ALPause23/Diplom/Презентация.pptx

## Аппаратно-программный комплекс измерения скорости объекта

Подготовил: Кабринович Е.Н.
Руководитель: байрак с.а.

## Цели и задачи

Целью данного дипломного проекта является разработка комплекса по измерению скорости объекта. Также, есть и дополнительные функции: измерение напряжения на аккумуляторной батарее автомобиля, часы реального времени с корректировкой, а также количество видимых устройством спутников.
- Проанализировать литературу.
- Составить структурную и функциональную схему прибора.
- Анализ и выбор необходимых компонентов.
- Разработка структуры программы управления контроллером.
- Составить электрическую принципиальную схему.
- Написание программного кода управления контроллером.

## Выбор навигационной системы

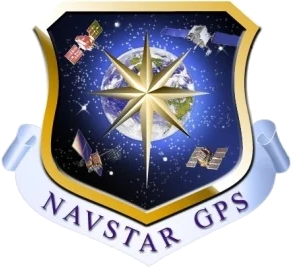
[picture p3: figure]
GPS — Википедия

VS

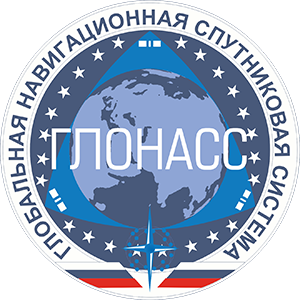
[picture p4: figure]
ГЛОНАСС (Глобальная навигационная спутниковая система ...

## Навигационная система GPS

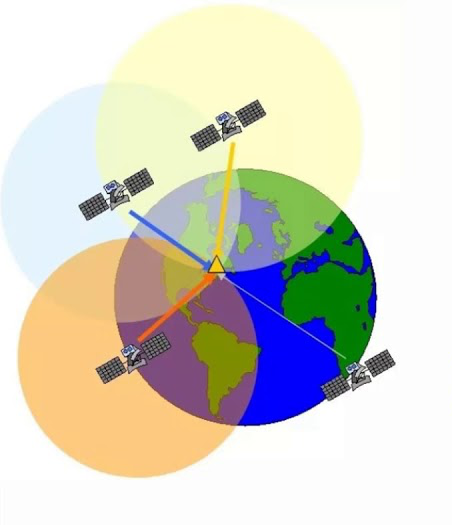
[picture p5: figure]
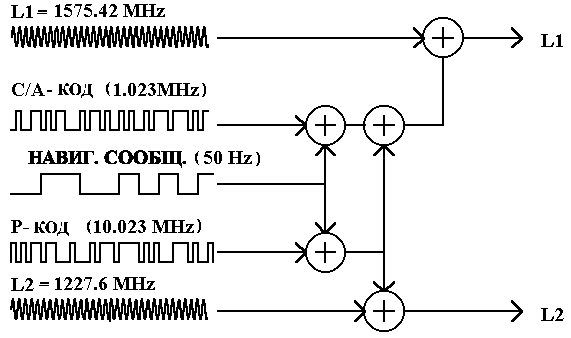
[picture p6: figure]
Кодирование радиосигнала

## Структура аппаратно-программного комплекса

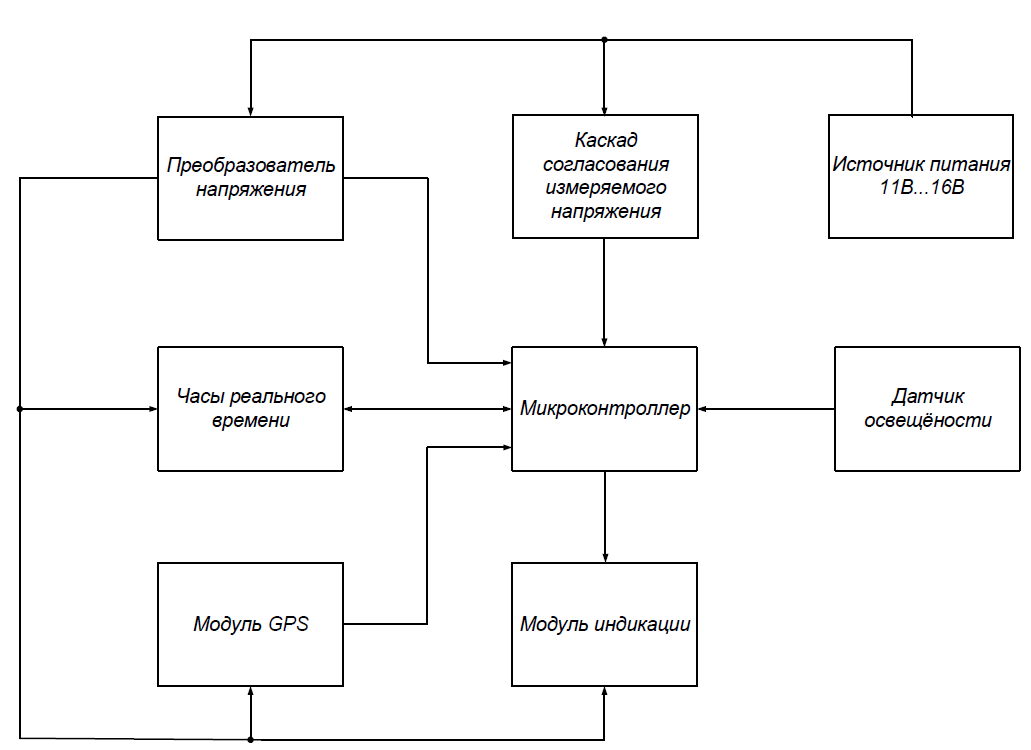
[picture p7: figure]

## Функционал аппаратно-программного комплекса

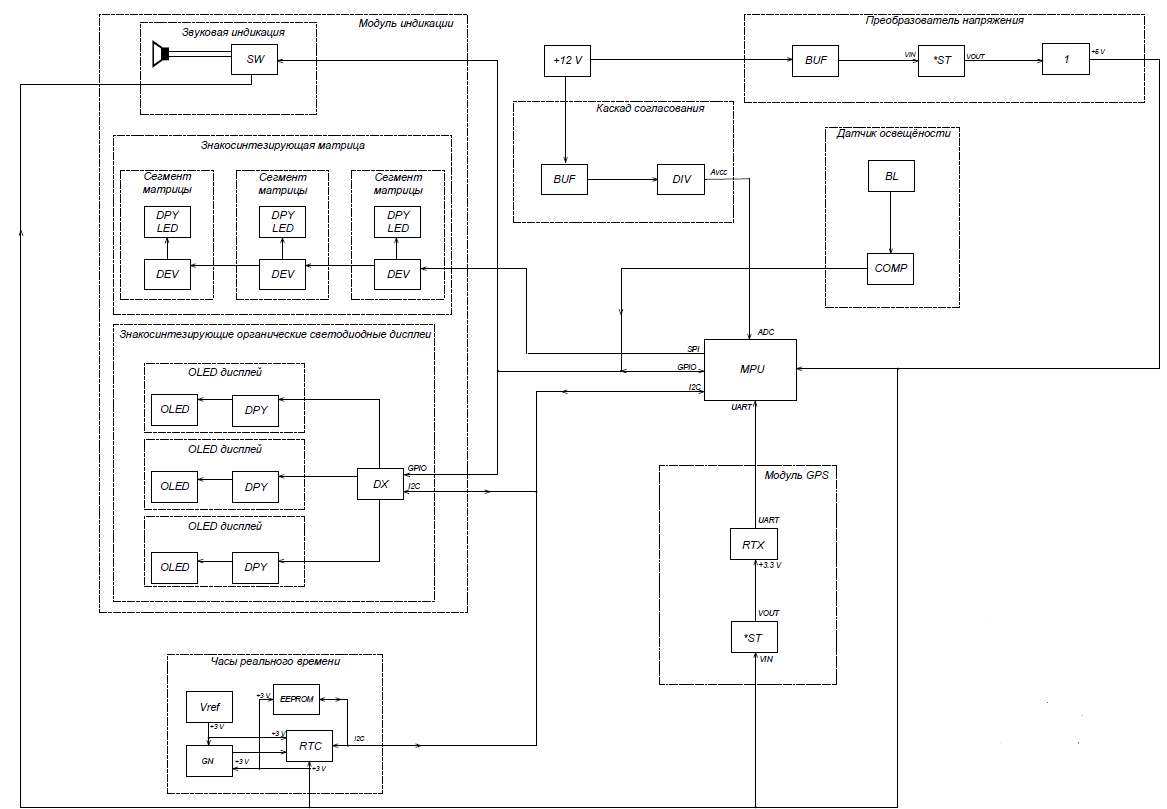
[picture p8: figure]

## Проектирование электрической принципиальной схемы

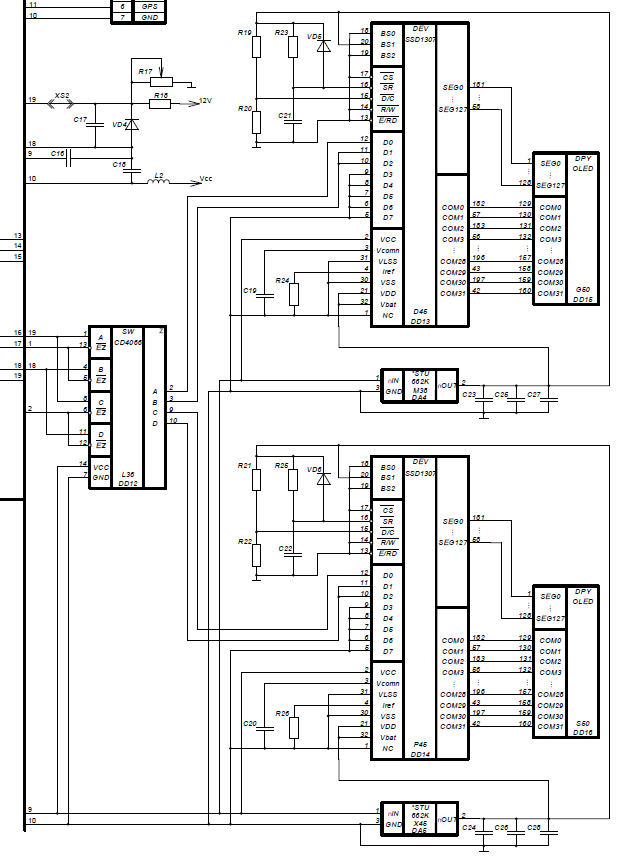
[picture p9: figure]

Основные особенности схемы

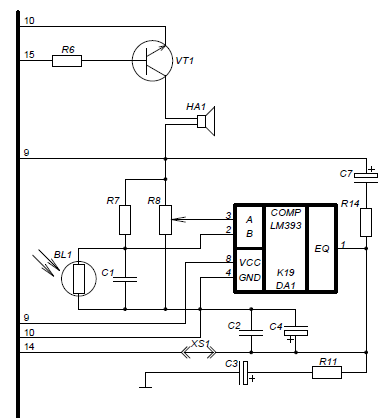
[picture p10: figure]

## Конструкционные особенности

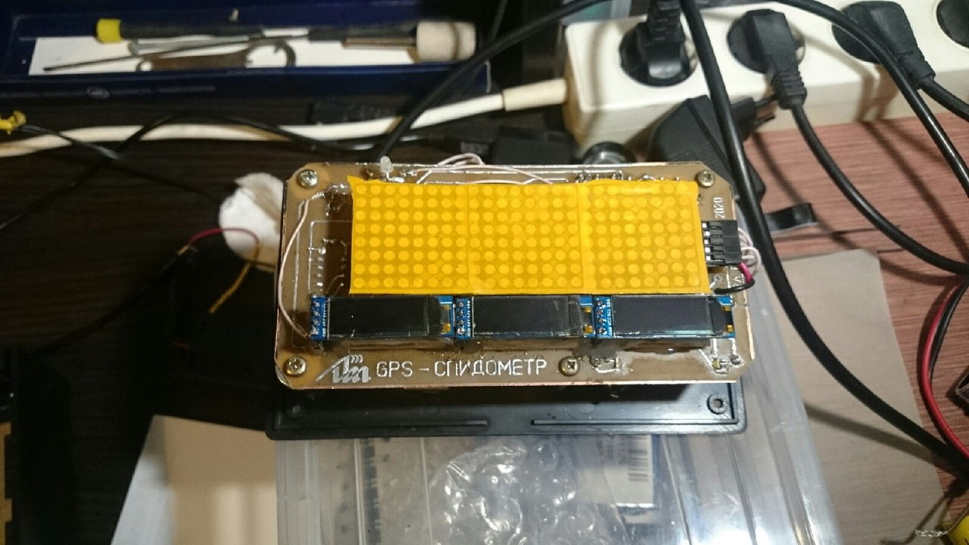
[picture p11: figure]

Отсутствие жёсткого разделения основной платы и блока индикации

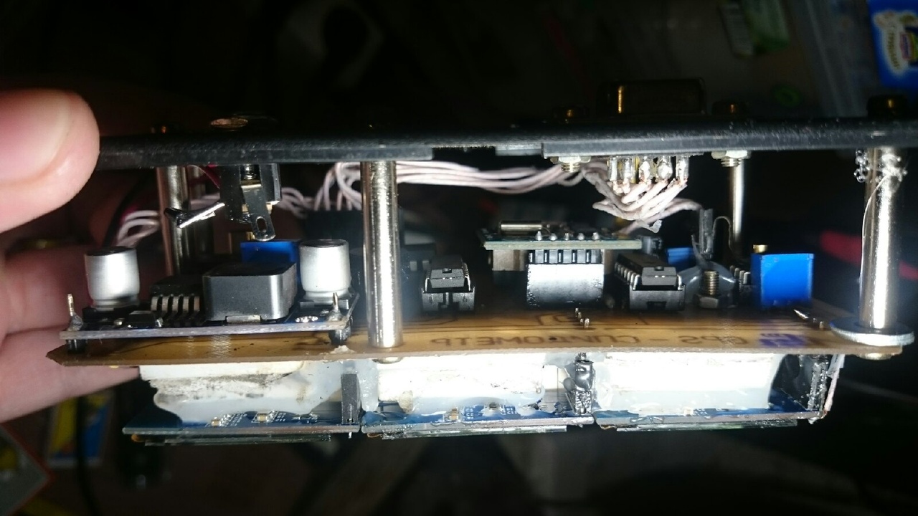
[picture p12: figure]

Размещение с двух сторон элементов
на односторонней плате

## Готовый прототип

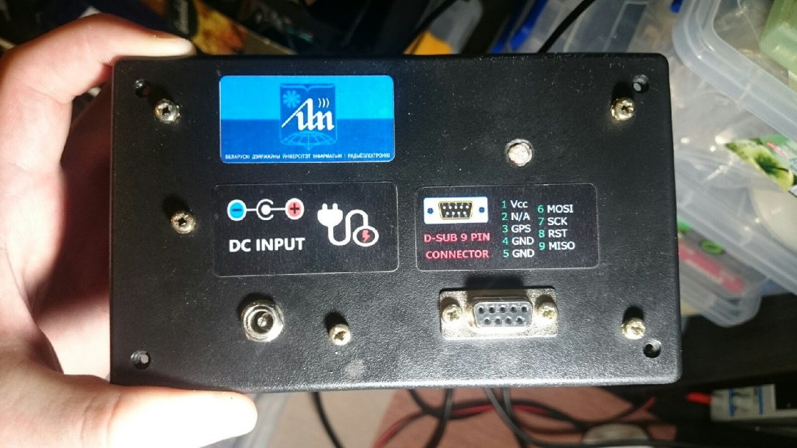
[picture p13: figure]

Вид спереди

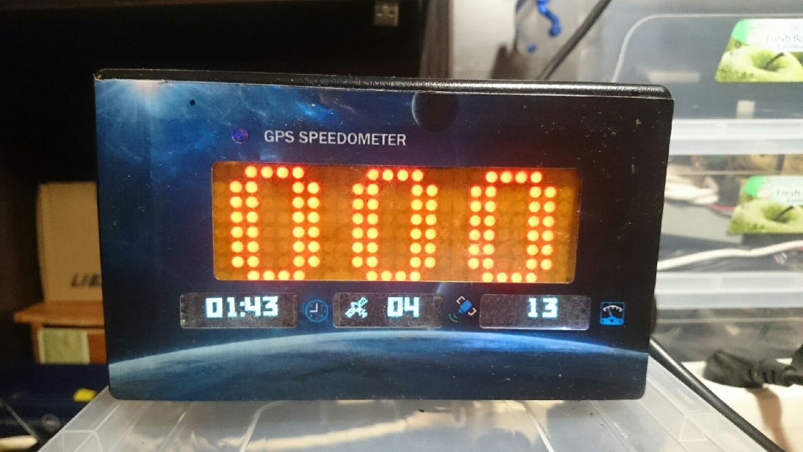
[picture p14: figure]

Вид сзади

## Выводы по данному проекту

- Разработанный в ходе дипломного проектирования аппаратно-программный комплекс измерению скорости объекта прибор, предназначенный для обработки протокола NMEA0813 с последующим отображением данных на элементах индикации. Дополнительными измеряемыми величинами являются такие как текущее время и напряжение питания. Прибор снабжен также звуковой сигнализацией.
- По результатам обзора литературных источников и расчетов были составлены электрическая структурная, электрическая функциональная и электрическая принципиальная схемы. На основании этих схем, была разработана конструкция печатной платы и сборочная документация для прибора, что позволило создать в рамках дипломного проекта опытный образец комплекса по измерению скорости объекта.

## Спасибо за внимание
