ALPause23/Diplom/01.ТЛ по ПДП.docx

Министерство образования Республики Беларусь

Учреждение образования

БЕЛОРУССКИЙ ГОСУДАРСТВЕННЫЙ УНИВЕРСИТЕТ

ИНФОРМАТИКИ И РАДИОЭЛЕКТРОНИКИ

Факультет компьютерных систем и сетей

Кафедра электронных вычислительных машин

Отчет по преддипломной практике

Студент Е.Н. Кабринович

Руководитель С.В. Черечень

Консультант от кафедры ЭВМ С.А. Байрак

Нормоконтролер А.С. Сидорович

МИНСК 2020
