ALPause23/Diplom/черновики на будущее..docx

Но несмотря на то, что с самого начала появления двух систем ГЛОНАСС явно опережал по развитию и точности NAVSTAR, развитие технологий в странах Запада, техническое отставание и экономический спад в СССР привели к тому, что на сегодняшний момент система ГЛОНАСС сильно проигрывает по точности и доступности GPS. Также, плохо налажена интеграция двух систем в единое целое. Конечно, это реализовано в системе Galileo, однако постоянное переключение контекста и расшифровка разных сообщений от разных систем делает малоперспективным данные системы – их быстродействие ставится под большое сомнение. Поэтому, была выбрана наиболее удачная, и наиболее доступная как аппаратно, так и программно система, а именно GPS. Далее в подразделе 1.5 будет подробнее рассмотрена данная система.
