ALPause23/Diplom/PDF/Заимствования.pdf

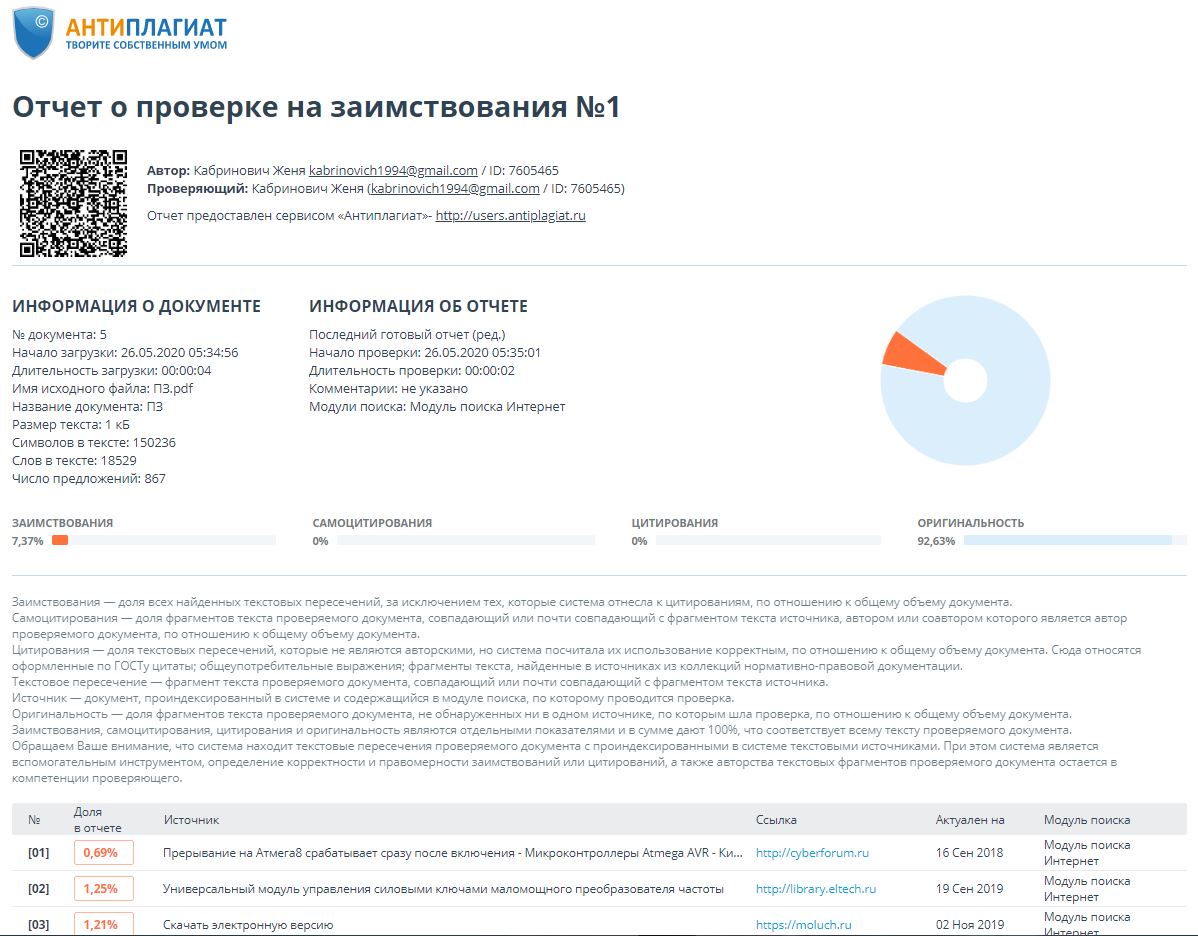
[picture p34: page 1]
