ALPause23/Diplom/PDF/Вводный плакат.pdf

## Аппаратно-программный комплекс измерения скорости объекта

### Цель:

•Разработка комплекса по измерению
скорости объекта На основе системы измерения геолокации.
•Создание минималистичного и простого для понимания интерфейс, с возможностью автоматической корректировки яркости. •Разработка системы измерение напряжения на аккумуляторной батарее автомобиля. •Встраивание часов реального времени с корректировкой.
•Отображение видимых устройством спутников.

### Задачи проекта:

•Проанализировать литературу. •Составить структурную и функциональную схему прибора.
•Анализ и выбор необходимых компонентов. •Разработка структуры программы управления контроллером.
•Составить электрическую принципиальную схему.
•Написание программного кода управления контроллером.

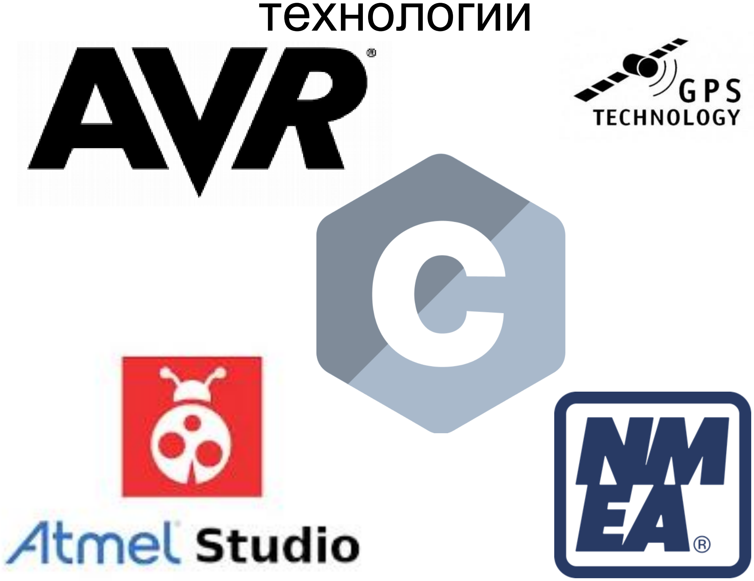
[picture p35: figure]
технологии

### Аналоги

### Средства разработки и

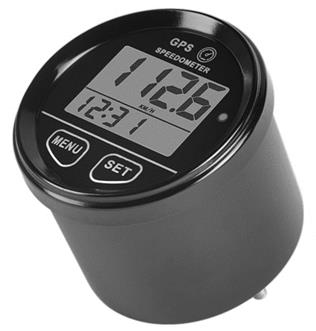
[picture p36: figure]
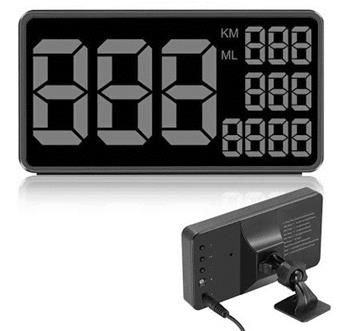
[picture p37: figure]
