ALPause23/Diplom/huita/Пахолкин А.О._504541_многофункциональный GPS-спидометр/Ведомость документов.pdf

Ôîðìàò À1

Ñõåìà ýëåêòðè÷åñêàÿ ïðèíöèïèàëüíàÿ ÃÓÈÐ.467859.003 Ý3

Èçì | Ëèñò | ¹ äîêóì. | Ïîäï. | Äàòà
| | Ðàçðàá. | Ïàõîëêèí | | | Ìíîãîôóíêöèîíàëüíûé GPS- ñïèäîìåòð Ведомость документов | Ëèò. | Ëèñò | Ëèñòîâ
Ïðîâåðèë | Íåõàé÷èê | | | | Ò | | | 108 | 108
Ò.êîíòð. | | | | | Êàôåäðà ÈÐÒ ãð. 504541
Í.êîíòð. | Êàëåíêîâè÷
Óòâ. | Ëèñòîïàä

## ÁÃÓÈÐ ÄÏ 1-08 01 01 02 013 Ä1

Îáîçíà÷åíèå | Íàèìåíîâàíèå | Äîïîëíèòåëü- íûå ñâåäåíèÿ
ÁÃÓÈÐ ÄÏ 1-08 01 01 02 013 ÏÇ | Ïîÿñíèòåëüíàÿ çàïèñêà | 108 ñ.
| Îòçûâ ðóêîâîäèòåëÿ | 1 ñ.
| Ðåöåíçèÿ | 1 ñ.

Òåêñòîâûå äîêóìåíòû

Ãðàôè÷åñêèå äîêóìåíòû

ÃÓÈÐ.687243.004 | ×åðòåæ ïå÷àòíîé ïëàòû

Ôîðìàò À1

ÃÓÈÐ.467859.005 ÑÁ | Ñáîðî÷íûé ÷åðòåæ

Ôîðìàò À1

ÃÓÈÐ.467859.001 Ý1 | Ñõåìà ýëåêòðè÷åñêàÿ ñòðóêòóðíàÿ

Ôîðìàò À1

ÃÓÈÐ.467859.002 Ý2

ÃÓÈÐ.467859.006 ÏË | Àëãîðèòì ðàáîòû ïðîãðàììû
| ìíîãîôóíêöèîíàëüíîãî GPS-ñïèäîìåòðà | Ôîðìàò À1

Ñõåìà ýëåêòðè÷åñêàÿ ôóíêöèîíàëüíàÿ

Ôîðìàò À1

Êîïèðîâàë | Ôîðìàò | À4

Èíâ. ¹ ïîäë. Ïîäï. è äàòà Âçàì. èíâ. ¹ Èíâ. ¹ äóáë. Ïîäï. è äàòà Ïåðâ. ïðèìåí. Ñïðàâ. ¹

Ýëåêòðîííûé íîñèòåëü èíôîðìàöèè ñ | CD-R

ïðîãðàììíûì îáåñïå÷åíèåì è ìàòåðèàëàìè
