ALPause23/Diplom/huita/Пахолкин А.О._504541_многофункциональный GPS-спидометр/Приложение Б.pdf

## ПРИЛОЖЕНИЕ Б (обязательное) Перечень элементов

Обозначение | Наименование | Примечание
А1 | GPS-модуль GY-NEO6MV2

Кол.

| Конденсаторы
С1 | EACP 1000 мкФ TKR102M1EG20 | 1 | 25В
C2 | SMD корпус 0805 X7R 510 пФ ±10% | 1
С3, С5…С7 | SMD корпус 0805 Y5V 0,1 µF ±10% | 4
С4 | EACP 4,7 мкФ TKR4R7M2EF11 | 1 | 250 В
C6 | EACP 10 мкФ TKR101M1AD11 | 1 | 10В

Микросхемы

DA1 | TEL 5-1211 | 1
DA2 | MC34063ABD-TR | 1
DD1 | ATmega16-16PU | 1
DD2 | SN74174N | 1
DD3 | DS1307ZN+, | 1
G1 | Элемент питания CR2032 PCB | 1
H1…H7 | Газоразрядный индикатор ИН-12А ОДО.334.079 ТУ | 1
HLA1 | Знакосинтезирующий дисплей WH1602L1-YGH-CT# | 1

Катушки индуктивности

L1 | 220 мкГн ±10% RLB1314-221KL | 1
L2 | 100 мкГн ±10% RLB0712-101KL | 1

## ГУИР.467859.007 ПЭ3

Изм | Лист | № докум | Подп. | Дата
Разраб. | Пахолкин | | | Многофункцональный GPS-спидометр Перечень элементов | Лит | Лист | Листов
Пров. | Нехайчик | | | | T | | | 1 | 3
Т.контр. | | | | | Кафедра ИРТ гр.504541
Н. Контр | Каленкович
Утв. | Листопад

| Резонаторы кварцевые
QZ1 | HC-SSG-32,768K | 1
QZ1 | HC-49SM | 1

Резисторы

R1 | KNP-200 0.22 Ом, 5% | 1 | 2 Вт.
R2…R3 | SMD корпус 0805 – 330 Ом ±5% | 2
R4 | SMD корпус 0805 – 1 MОм ±5% | 1
R5 | 3362H-1-474LF – 470 кОм ±5% | 1
R6 | SMD корпус 0805 – 10 кОм ±5% | 1
R7…R20 | SMD корпус 0805 – 1 MОм ±5% | 14
R21…R27 | SMD корпус 0805 – 13 кОм ±5% | 7
R28 | SMD корпус 0805 – 10 кОм ±5% | 1
R29 | 3362H-1-103LF – 10 кОм ±5% | 1
R30 | SMD корпус 0805 – 10 кОм ±5% | 1
R31…R33 | SMD корпус 0805 – 4,7 кОм ±5% | 3
R34 | SMD корпус 0805 – 1 кОм ±5% | 1
R35 | 3362H-1-103LF – 10 кОм ±5% | 1
SB | Выключатель клавишный KCD1-102-C3-B/3P | 1
VD1 | Диод HER205 | 1
| Транзисторы | 1
VT1 | BC847.215 | 1
VT2 | BC846.215 | 1
VT3 | IRF840APBF | 1
VT4 | BC817-16.215 | 1
VT5…VT11 | MMBTA42LT1G | 7
VT12…VT18 | MMBTA92LT1G | 7

## ГУИР.467859.0107 ПЭ3

Лист
2
Изм | Лист | № докум | Подп. | Дата

Разьемы

XP1, XP4 | CWF-2 | 2
XP2, XP5 | XH-10-M | 2
XP3 | CWF-3 | 1
XP6 | XH-07-M | 1
XP7 | DC-016 2.4mm | 1
XP8, XP10 | PAP-02V-S | 2
XP9, XP11. | H-08 10 pin | 2
XP12 | H-07 7 Pin | 1

## ГУИР.467859.007 ПЭ3

Лист
3
Изм | Лист | № докум | Подп. | Дата
