ALPause23/Diplom/huita/Пахолкин А.О._504541_многофункциональный GPS-спидометр/Приложение В.pdf

ПРИЛОЖЕНИЕ В
(обязательное)
Справка о процентной оценки оригинальности текста

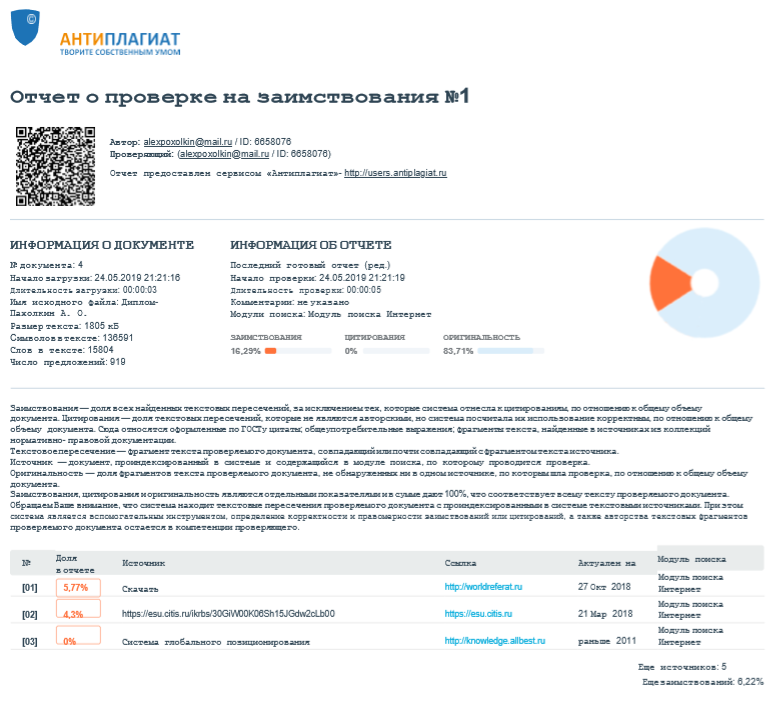
[picture p63: figure]

Рисунок В.1 – Справка о процентной оценки оригинальности текста
