ALPause23/Diplom/huita/Пахолкин А.О._504541_многофункциональный GPS-спидометр/титульный лист.pdf

Министерство образования Республики Беларусь

Учреждение образования
БЕЛОРУССКИЙ ГОСУДАРСТВЕННЫЙ УНИВЕРСИТЕТ ИНФОРМАТИКИ И РАДИОЭЛЕКТРОНИКИ

Факультет инновационного непрерывного образования

Кафедра информационных радиотехнологий

К защите допустить:
Заведующий кафедрой ИРТ
Н.И. Листопад

ПОЯСНИТЕЛЬНАЯ ЗАПИСКА
дипломного проекта
на тему

МНОГОФУНКЦИОНАЛЬНЫЙ GPS-СПИДОМЕТР

БГУИР ДП 1-08 01 01 02 013 ПЗ

Студент | А.О. Пахолкин
Руководитель | Е.В. Нехайчик

Консультанты:

от кафедры ИРТ | Е.В. Нехайчик
по экономической части | Т.Е. Наганова
по методическому разделу | Т.А. Парафиянович
Нормоконтролер | Е.Н. Каленкович

Рецензент

Минск 2019

Решением рабочей комиссии
допущен к защите дипломного проекта Председатель рабочей комиссии

_______________ ( ___________________ )

Подпись | Инициалы и фамилия

«___» июня 2019 г.
