ALPause23/Diplom/huita/Пахолкин А.О._504541_многофункциональный GPS-спидометр/чертежи/PDF/ГУИР.467859.001 Э1.pdf

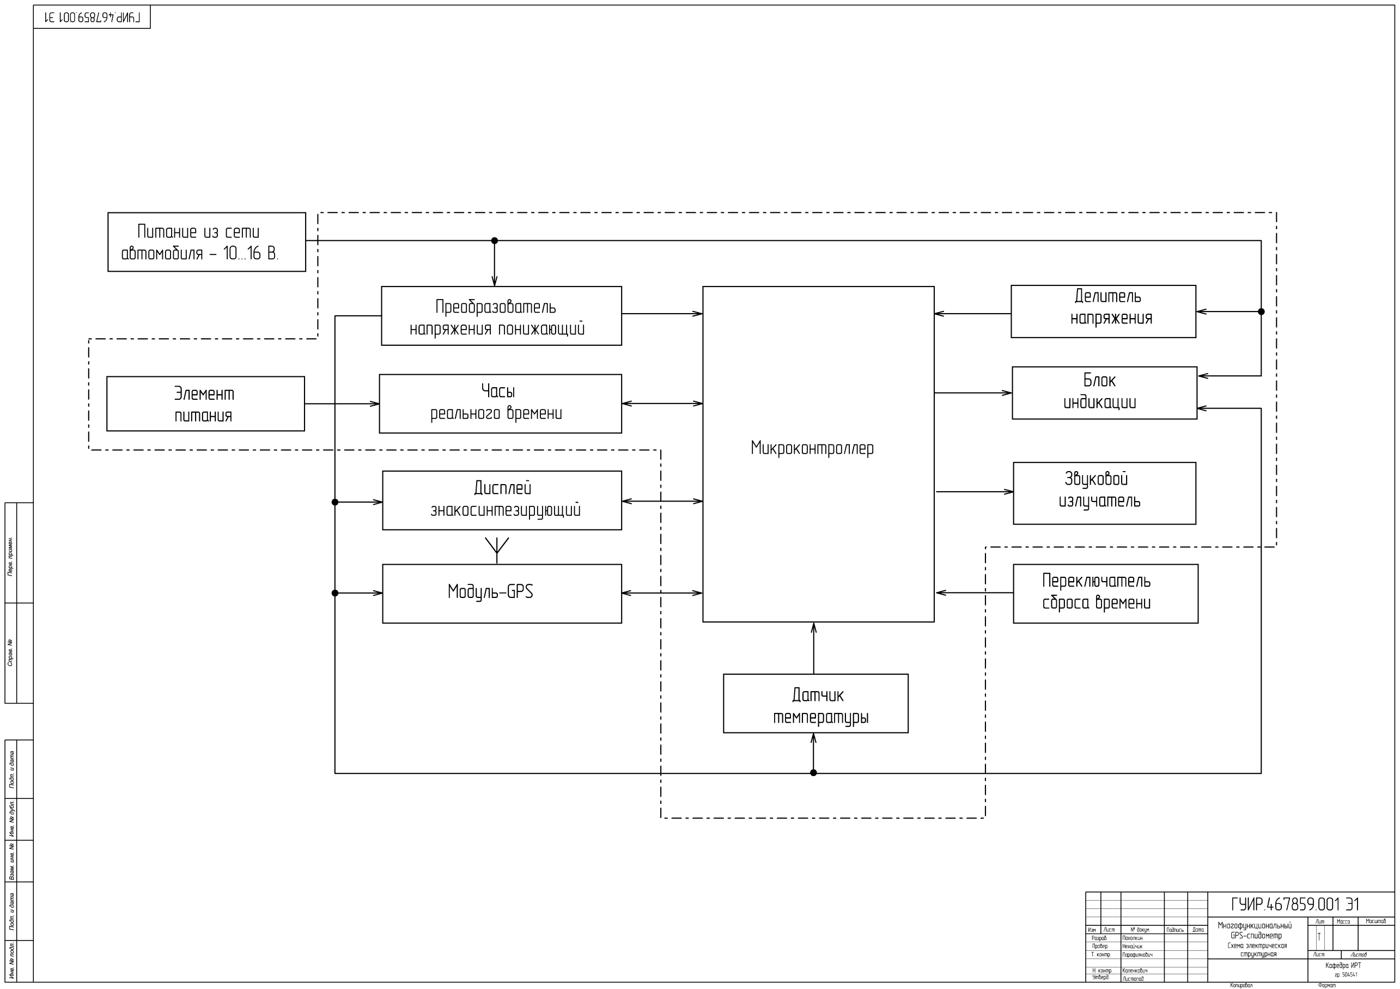
[picture p64: page 1]
