ALPause23/Diplom/huita/Пахолкин А.О._504541_многофункциональный GPS-спидометр/чертежи/PDF/ГУИР.467859.002 Э2.pdf

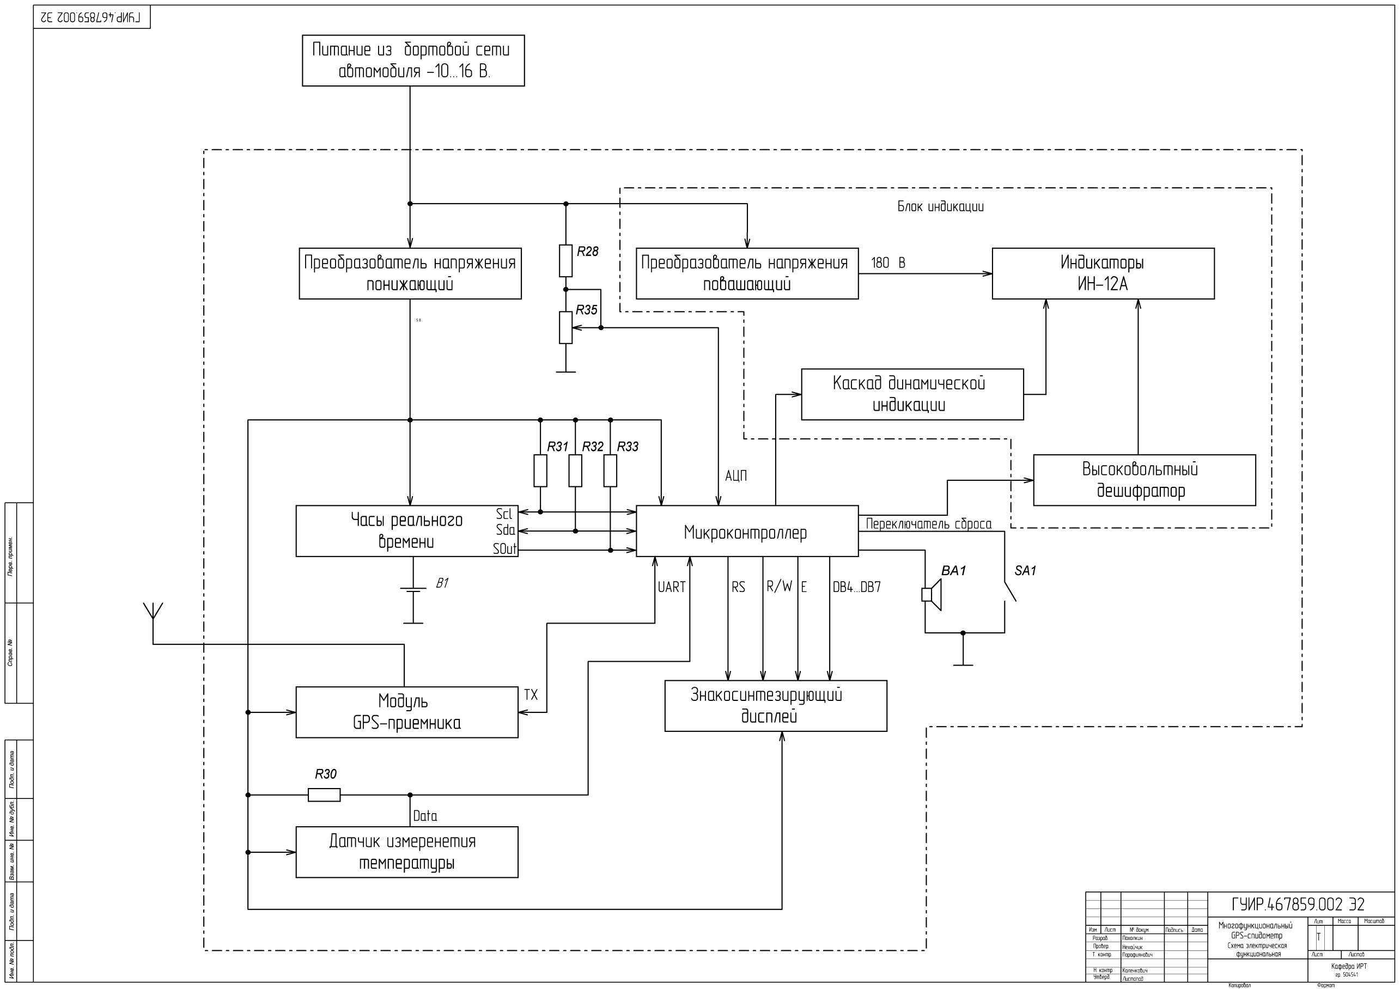
[picture p65: page 1]
