ALPause23/Diplom/huita/Пахолкин А.О._504541_многофункциональный GPS-спидометр/чертежи/PDF/ГУИР.467859.006 ПЛ.pdf

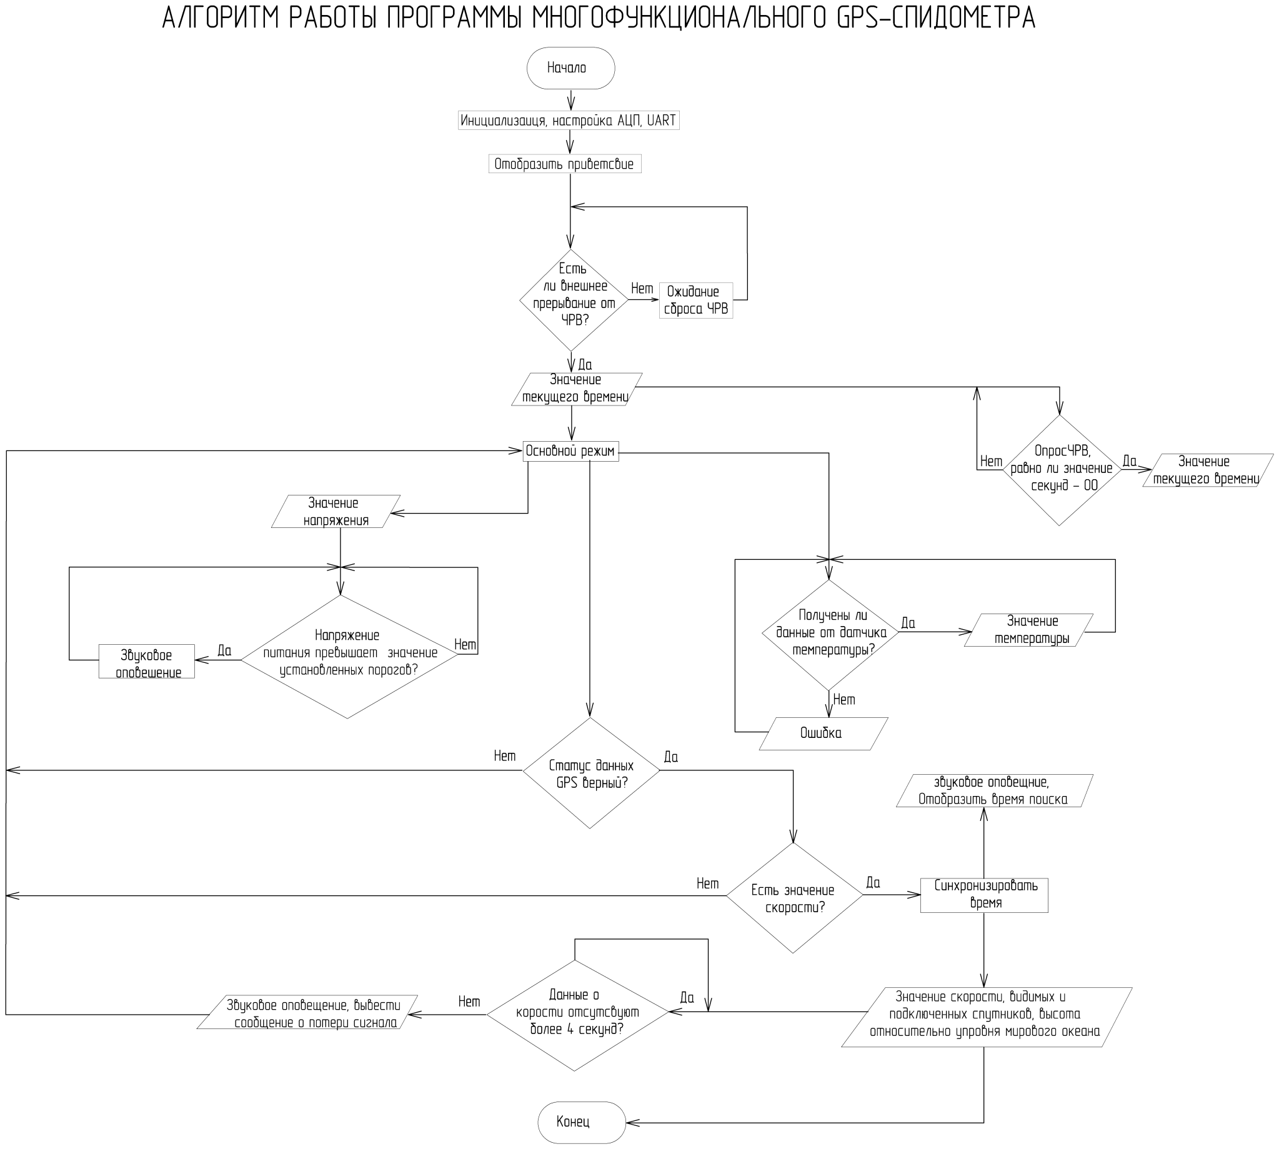
[picture p66: page 1]
