ALPause23/Diplom/huita/Пахолкин А.О._504541_многофункциональный GPS-спидометр/чертежи/PDF/Вспомогательный материал/Э2.JPG

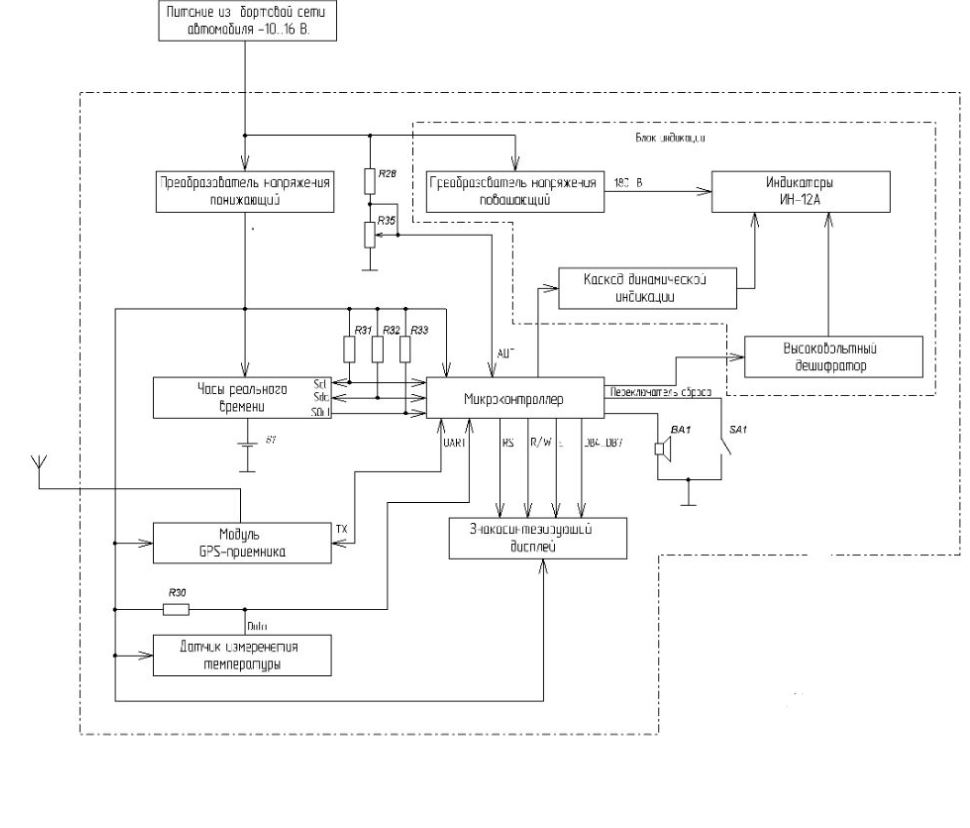
huita/Пахолкин А.О._504541_многофункциональный GPS-спидометр/чертежи/PDF/Вспомогательный материал/Э2.JPG
