ALPause23/Diplom/huita/Пахолкин А.О._504541_многофункциональный GPS-спидометр/чертежи/ПОВЫШАЮЩИЙ.JPG

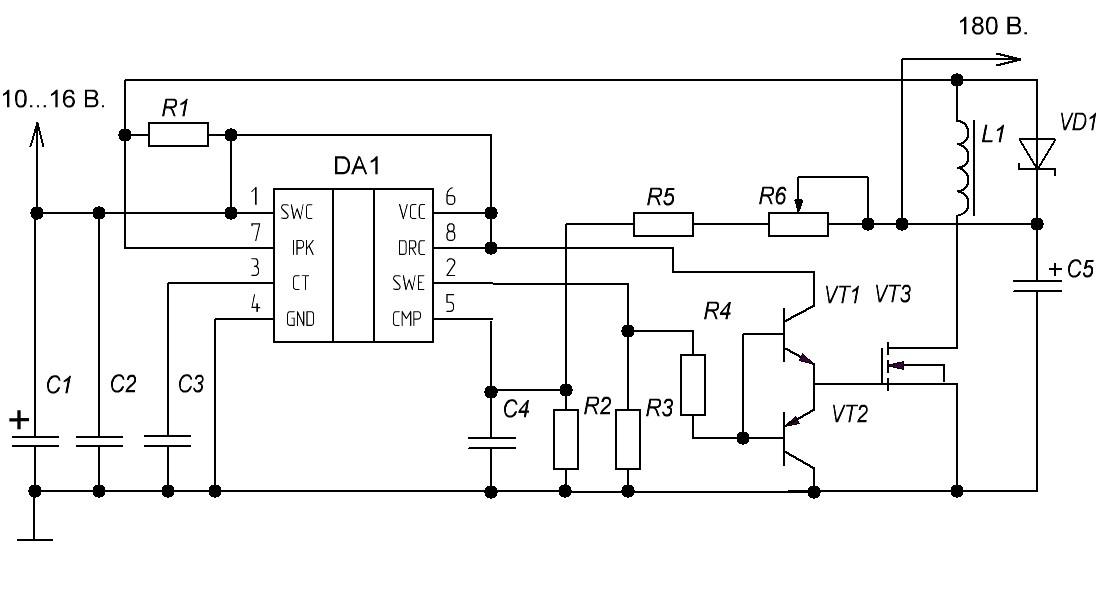
huita/Пахолкин А.О._504541_многофункциональный GPS-спидометр/чертежи/ПОВЫШАЮЩИЙ.JPG
