ALPause23/Diplom/huita/Пахолкин А.О._504541_многофункциональный GPS-спидометр/чертежи/Согласование.JPG

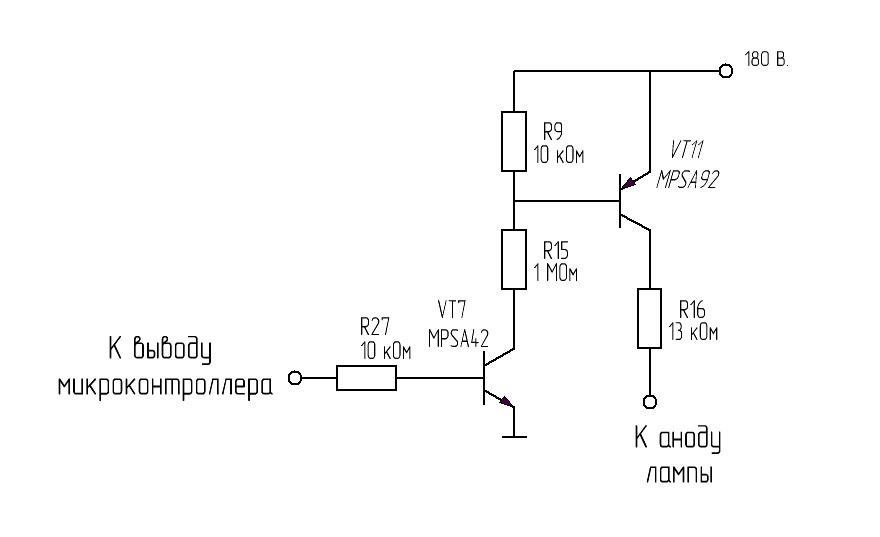
huita/Пахолкин А.О._504541_многофункциональный GPS-спидометр/чертежи/Согласование.JPG
