ALPause23/Diplom/Shema/PA1.JPG

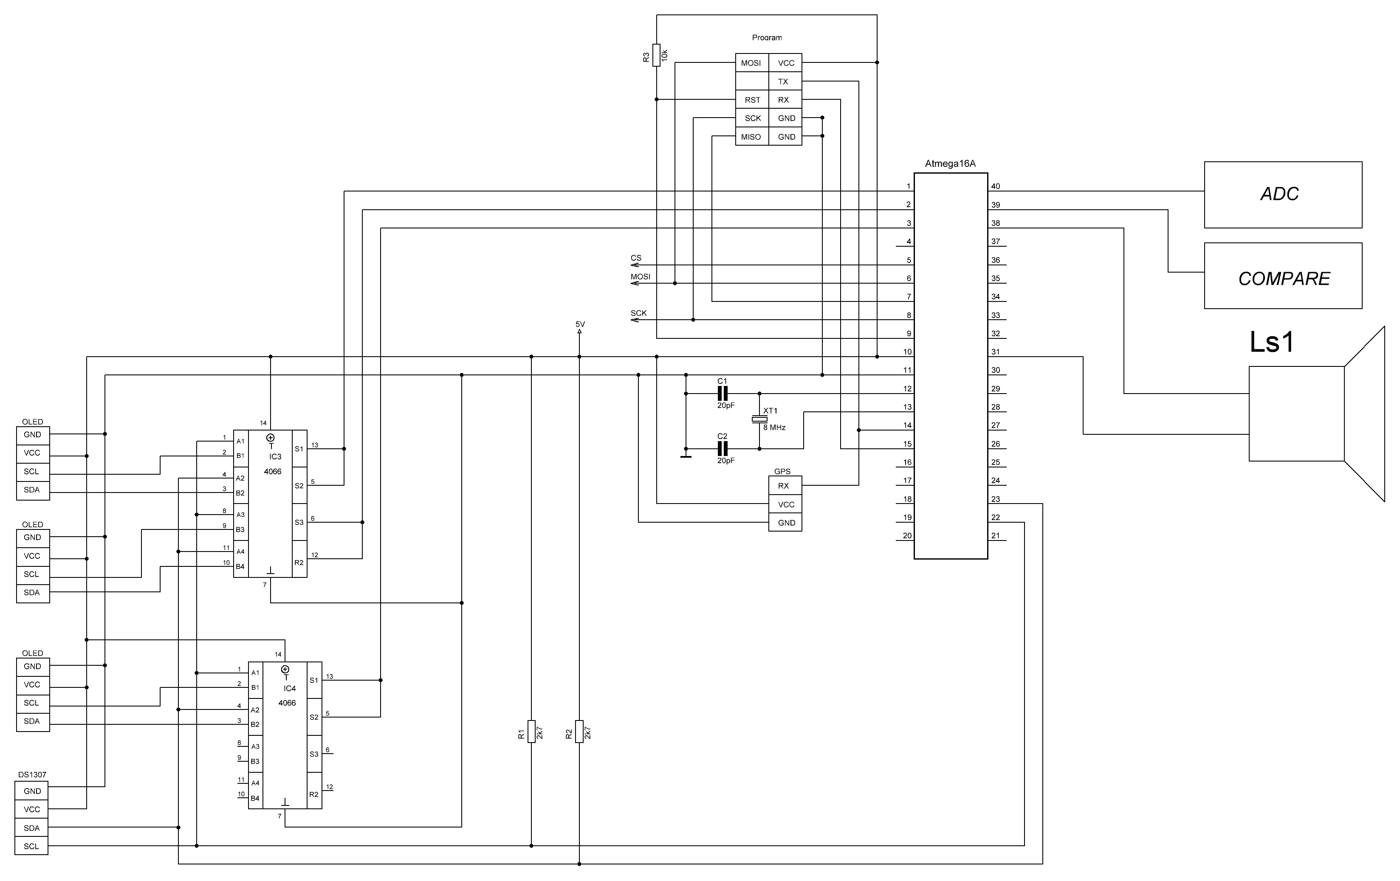
Shema/PA1.JPG
