ALPause23/Diplom/(list of files, cad)

Other CAD files:
huita/Пахолкин А.О._504541_многофункциональный GPS-спидометр/чертежи/Рамка А1-горизонтальное расположение.dwg
huita/Пахолкин А.О._504541_многофункциональный GPS-спидометр/чертежи/Э1.dwg
huita/Пахолкин А.О._504541_многофункциональный GPS-спидометр/чертежи/Э3.dwg
huita/Пахолкин А.О._504541_многофункциональный GPS-спидометр/чертежи/СБ.dwg
huita/Пахолкин А.О._504541_многофункциональный GPS-спидометр/чертежи/ЧПП.dwg
huita/Пахолкин А.О._504541_многофункциональный GPS-спидометр/чертежи/Э2.dwg
