ALPause23/Diplom/PDF/Э3.pdf

D

A

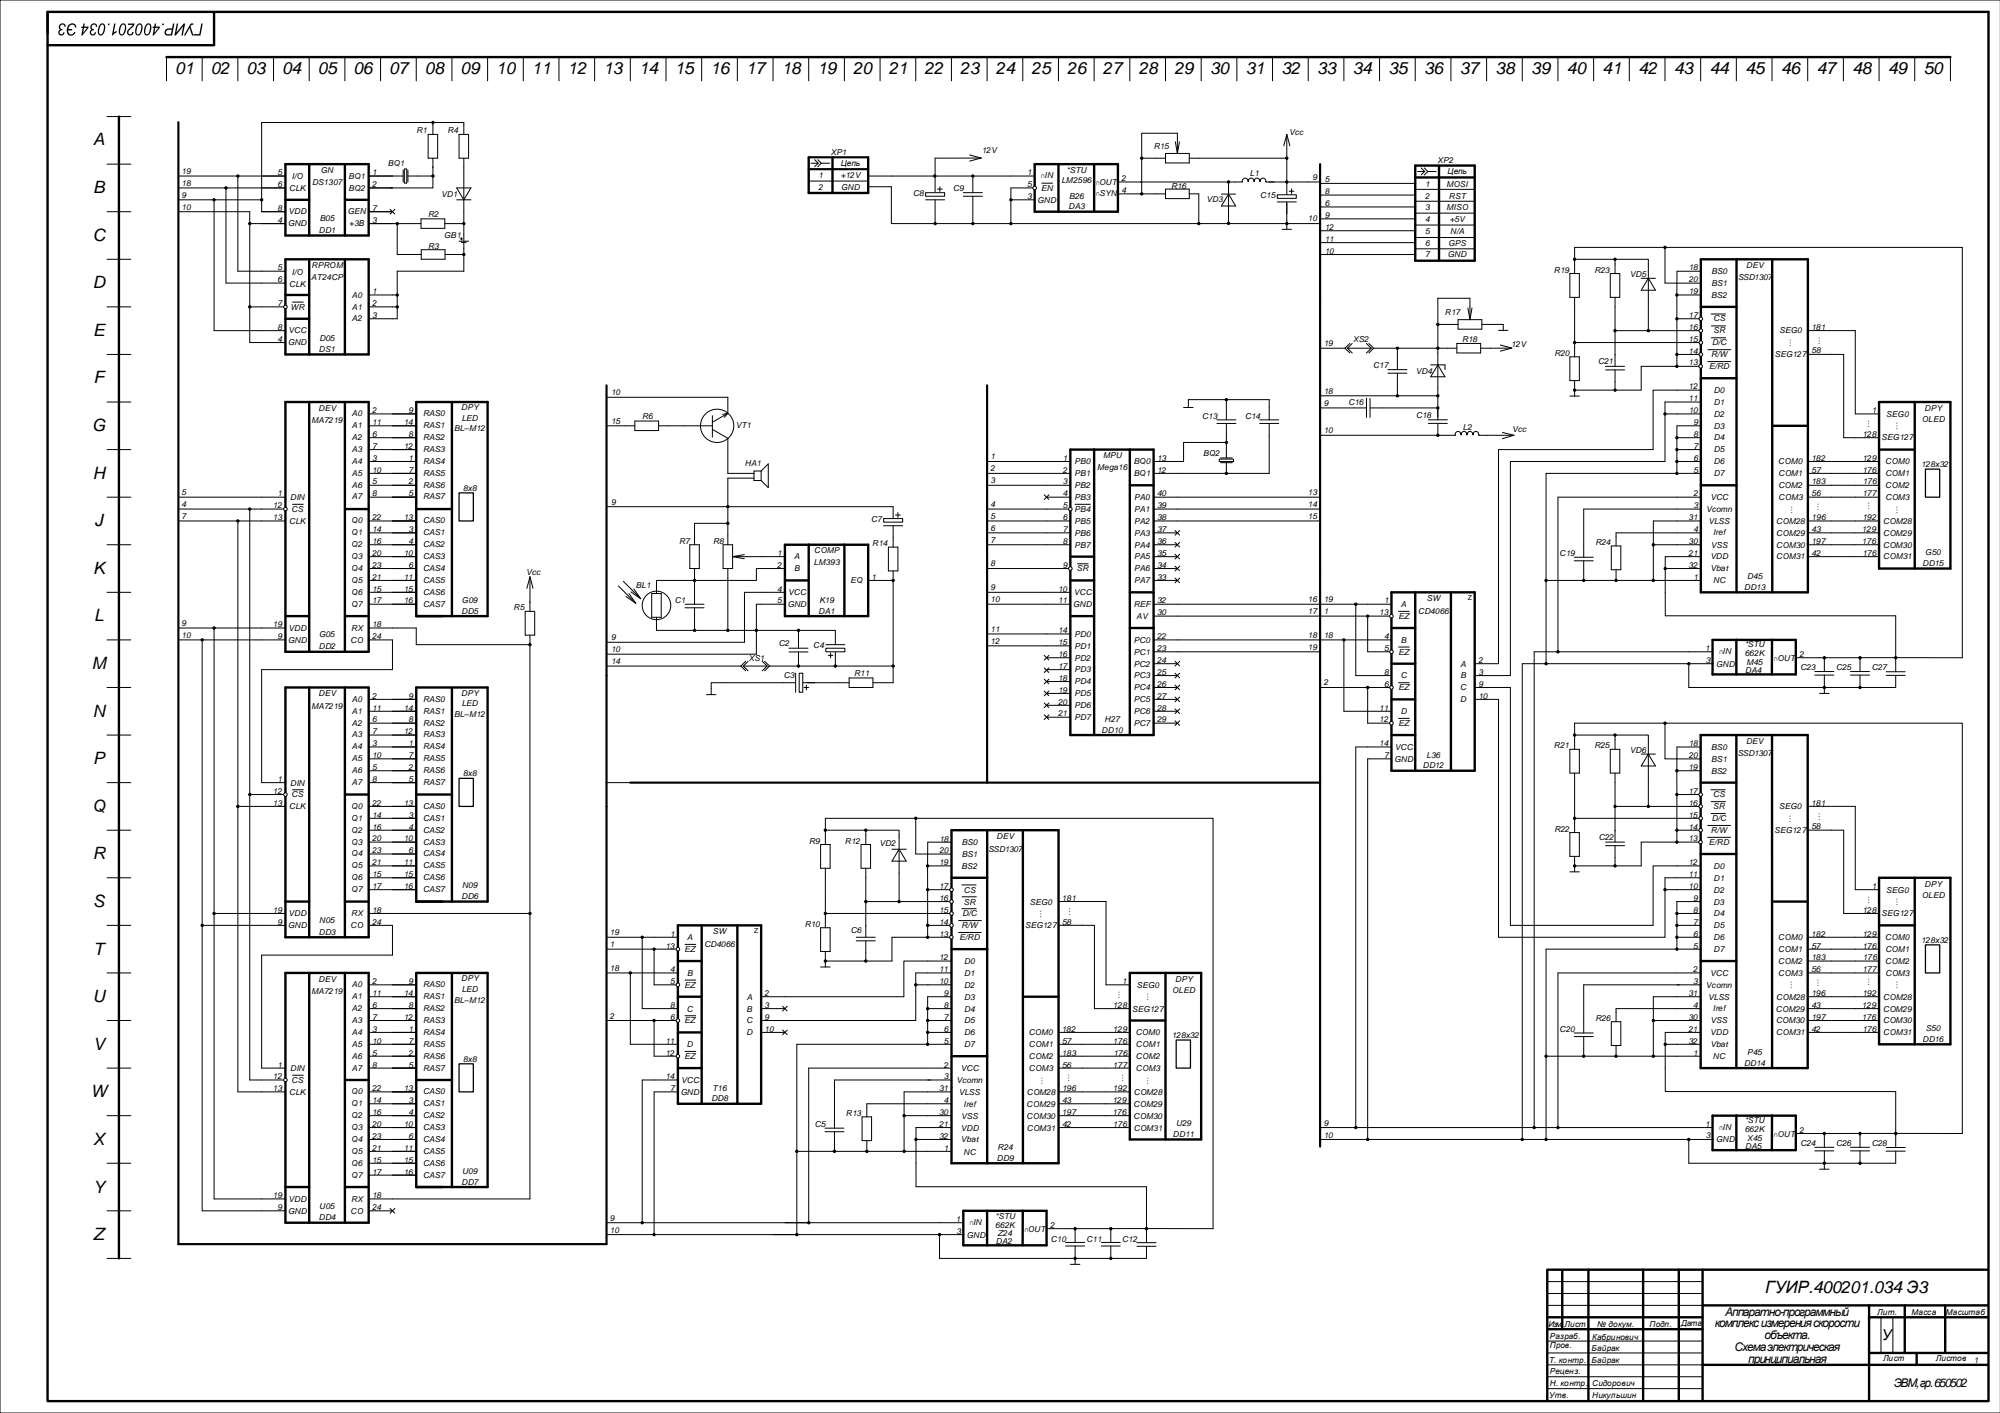
[picture p73: page 1]

Цепь
1 | +12V
2 | GND

6 | GPS
7 | GND

VDD GND | CO

ГУИР.400201.034 Э3

Аппаратно-программный комплекс измерения скорости объекта. Схема электрическая принципиальная | Лит. | Масса | Масштаб

Изм.Лист | | № докум. | Подп. | Дата | | | У
Разраб. | | Кабринович
Пров. | | Байрак
Т. контр. | Байрак | | | | Лист | Листов 1
Реценз.
Н. контр. | Сидорович
