ALPause23/Diplom/PDF/Э2.pdf

## Модуль индикации

## Каскад согласования

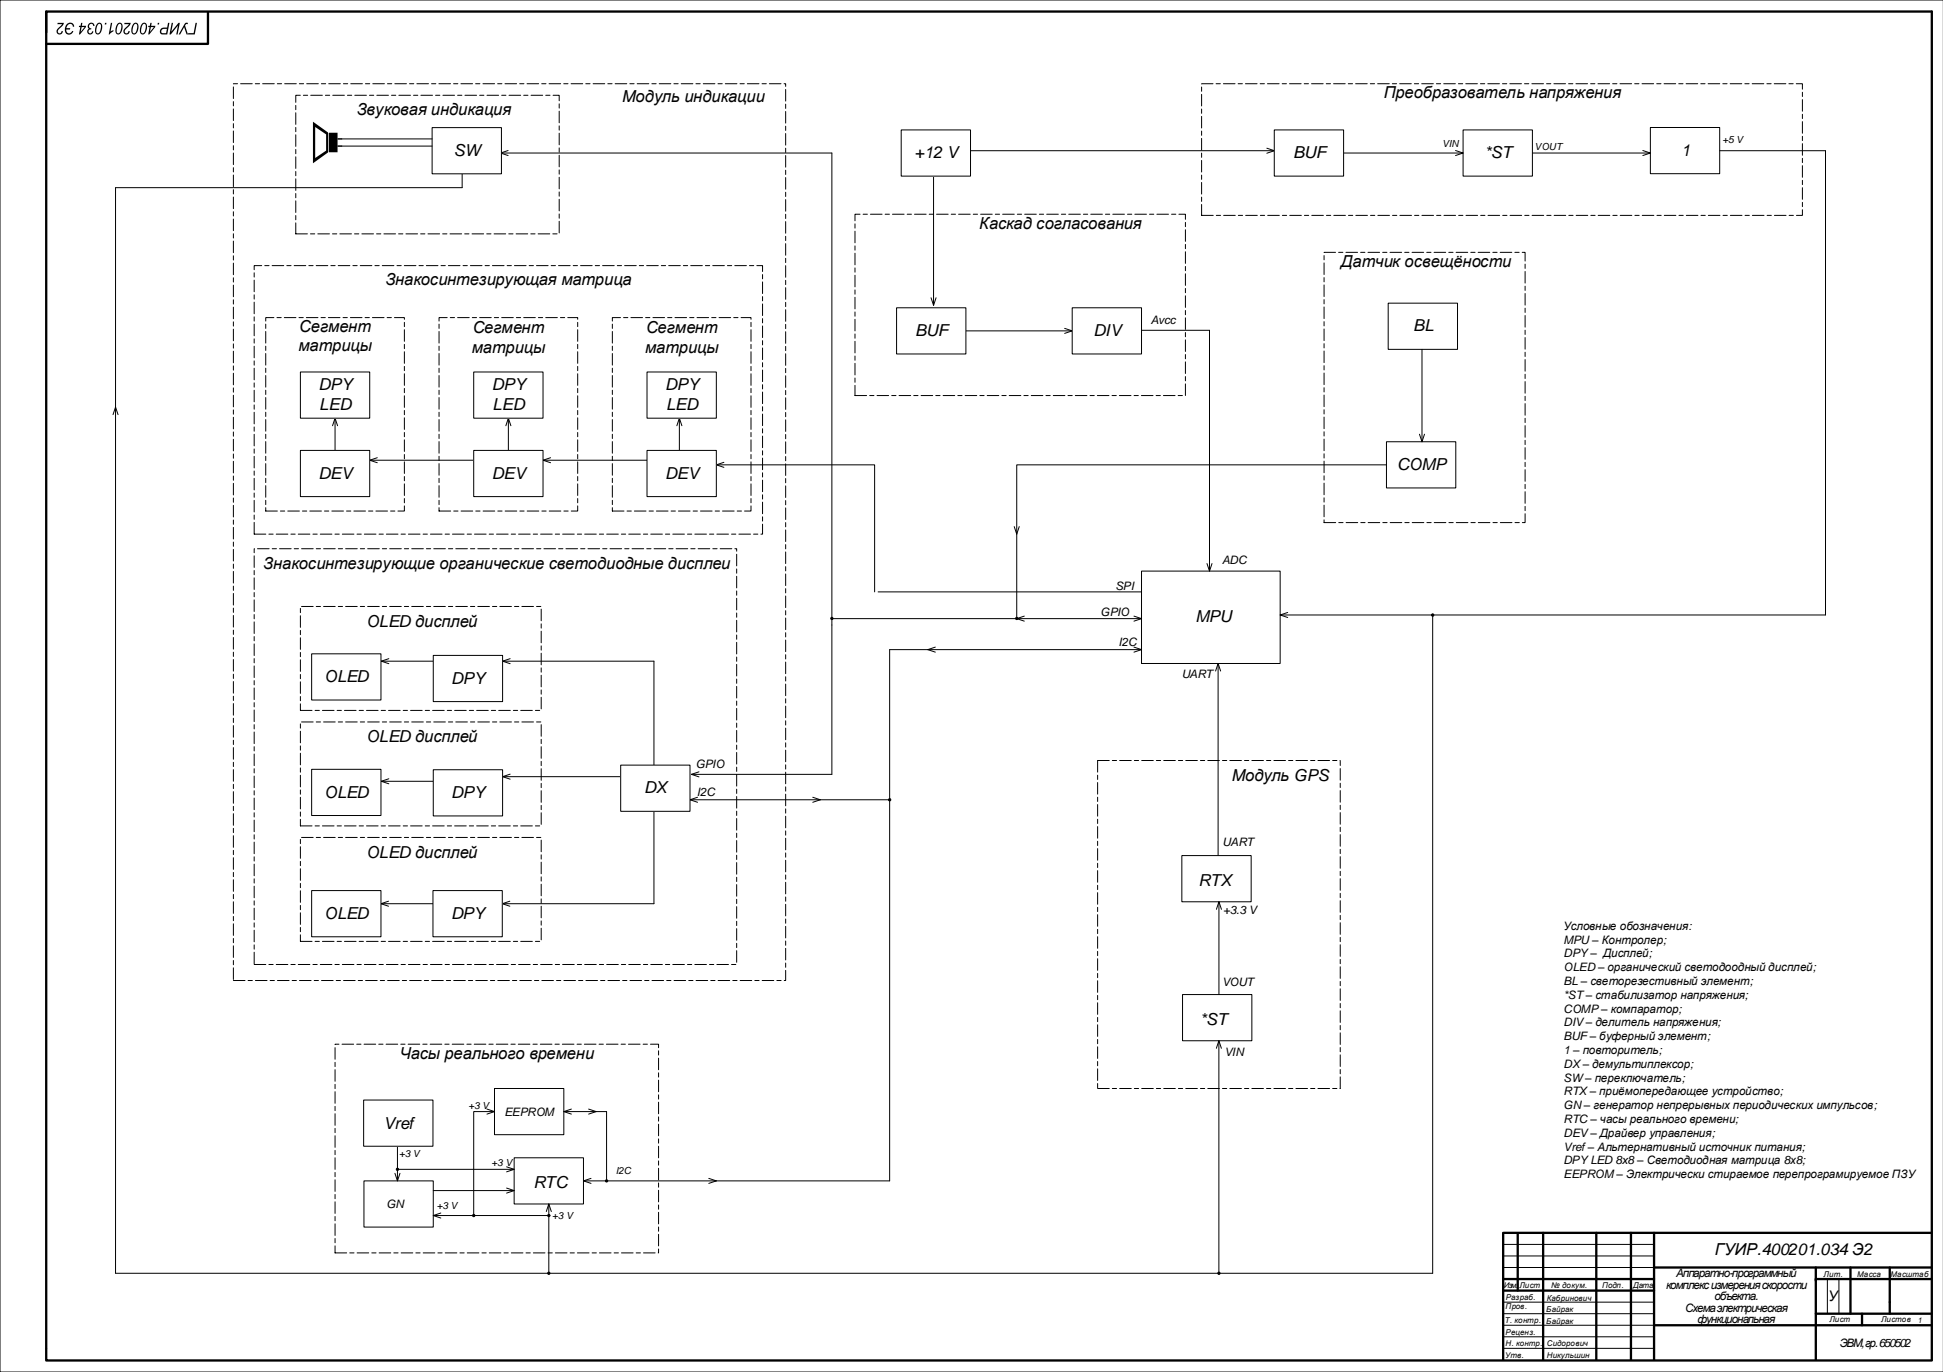
[picture p74: page 1]
GPIO; SPI; UART; ADC; OLED дисплей; Никульшин; Утв.; ЭВМ, гр. 650502; Модуль GPS; Преобразователь напряжения; COMP; Датчик освещёности; Звуковая индикация; Сегмент матрицы; Знакосинтезирующая матрица; VIN; VOUT; Avcc; OLED; DPY; Vref; MPU; BUF; DIV; DEV; DPY LED; RTX; EEPROM; RTC

Знакосинтезирующие органические светодиодные дисплеи

Условные обозначения:
MPU – Контролер;
DPY – Дисплей;
OLED – органический светодоодный дисплей;
BL – светорезестивный элемент;
*ST – стабилизатор напряжения;
COMP – компаратор;
DIV – делитель напряжения;
BUF – буферный элемент;
1 – повторитель;
DX – демультиплексор;
SW – переключатель;
RTX – приёмопередающее устройство;
GN – генератор непрерывных периодических импульсов;
RTC – часы реального времени;
DEV – Драйвер управления;
Vref – Альтернативный источник питания;
DPY LED 8x8 – Светодиодная матрица 8х8;
EEPROM – Электрически стираемое перепрограмируемое ПЗУ

Часы реального времени

ГУИР.400201.034 Э2

Аппаратно-программный комплекс измерения скорости объекта. Схема электрическая функциональная | Лит. | Масса | Масштаб

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
