ALPause23/Diplom/Вводный плакат_рамка а1.pdf

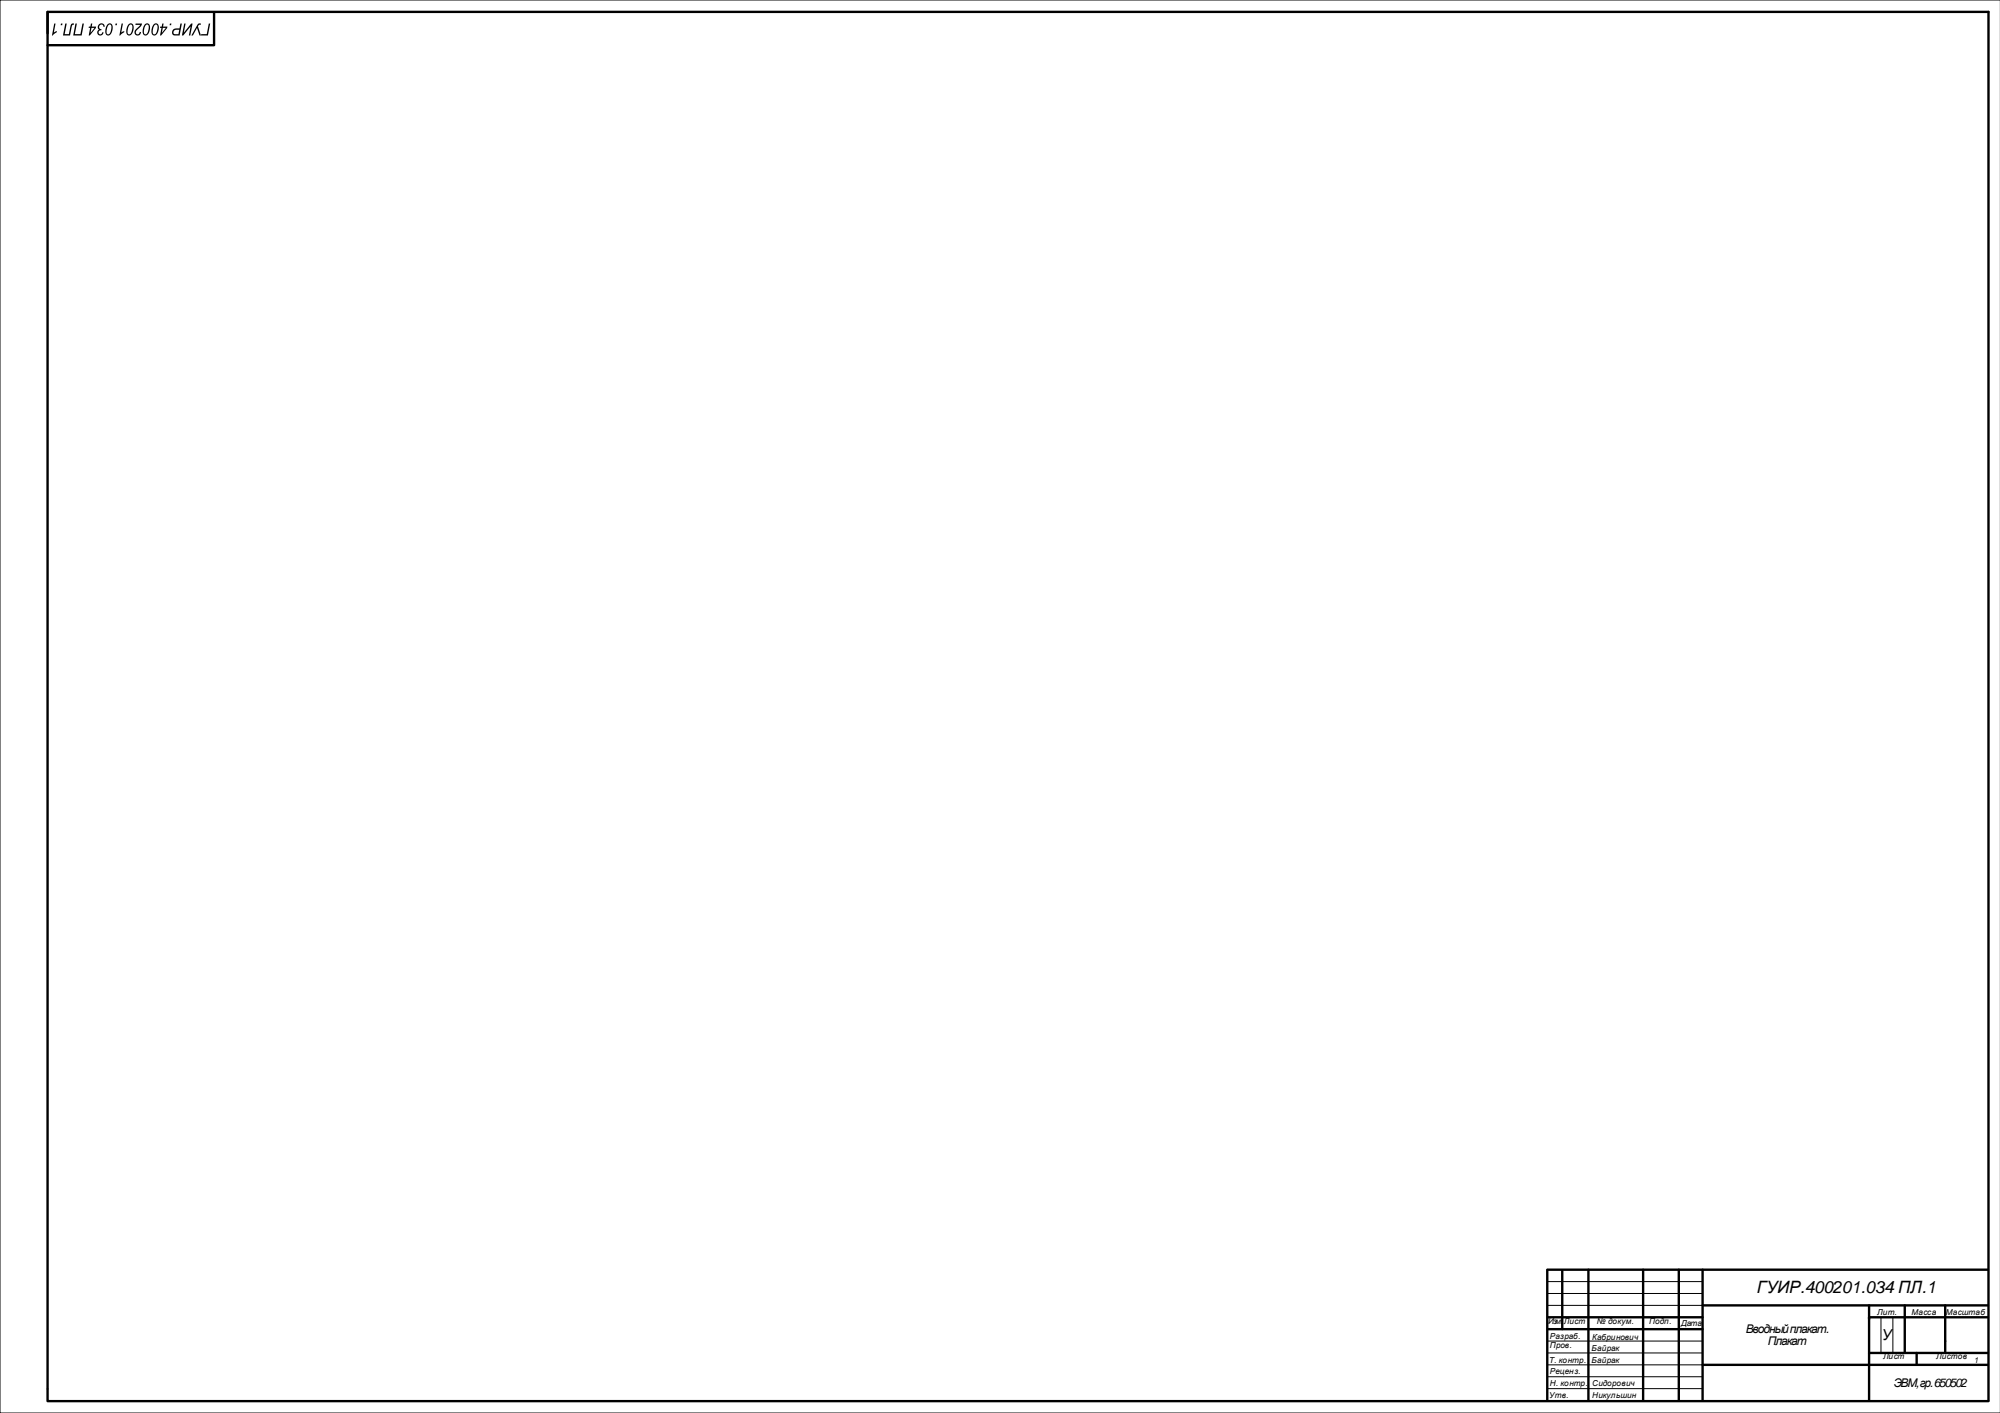
[picture p75: page 1]
Никульшин; Утв.; ЭВМ, гр. 650502

ГУИР.400201.034 ПЛ.1

Вводный плакат. Плакат | Лит. | Масса | Масштаб

Изм.Лист | | № докум. | Подп. | Дата | | | У

Разраб. | | Кабринович
Пров. | | Байрак
Т. контр. | Байрак | | | | Лист | Листов 1

Реценз.
Н. контр. | Сидорович
