ALPause23/Diplom/PDF/Заключительный плакат.pdf

# Аппаратно-программный комплекс измерения скорости объекта

### Результат выполненной работы

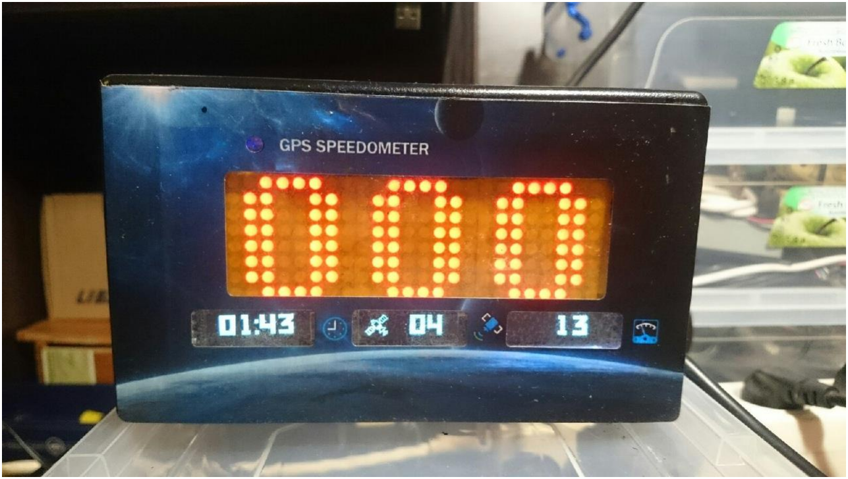
[picture p76: figure]
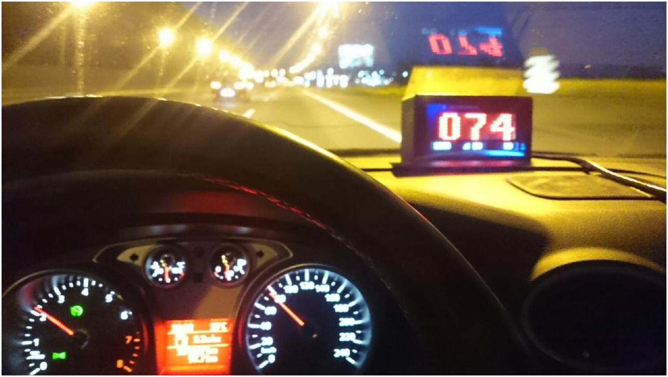
[picture p77: figure]

ПРЕИМУЩЕСТВА | ВОЗМОЖНЫЕ УЛУЧШЕНИЯ
| •Улучшение конструкции •Повышение быстродействия •Переход на SMD компоненты •Переход к встраиваемой ОС

•Простота конструкции
•Простая эргономика
•Низкое энергопотребление
•Саморегулировка яркости

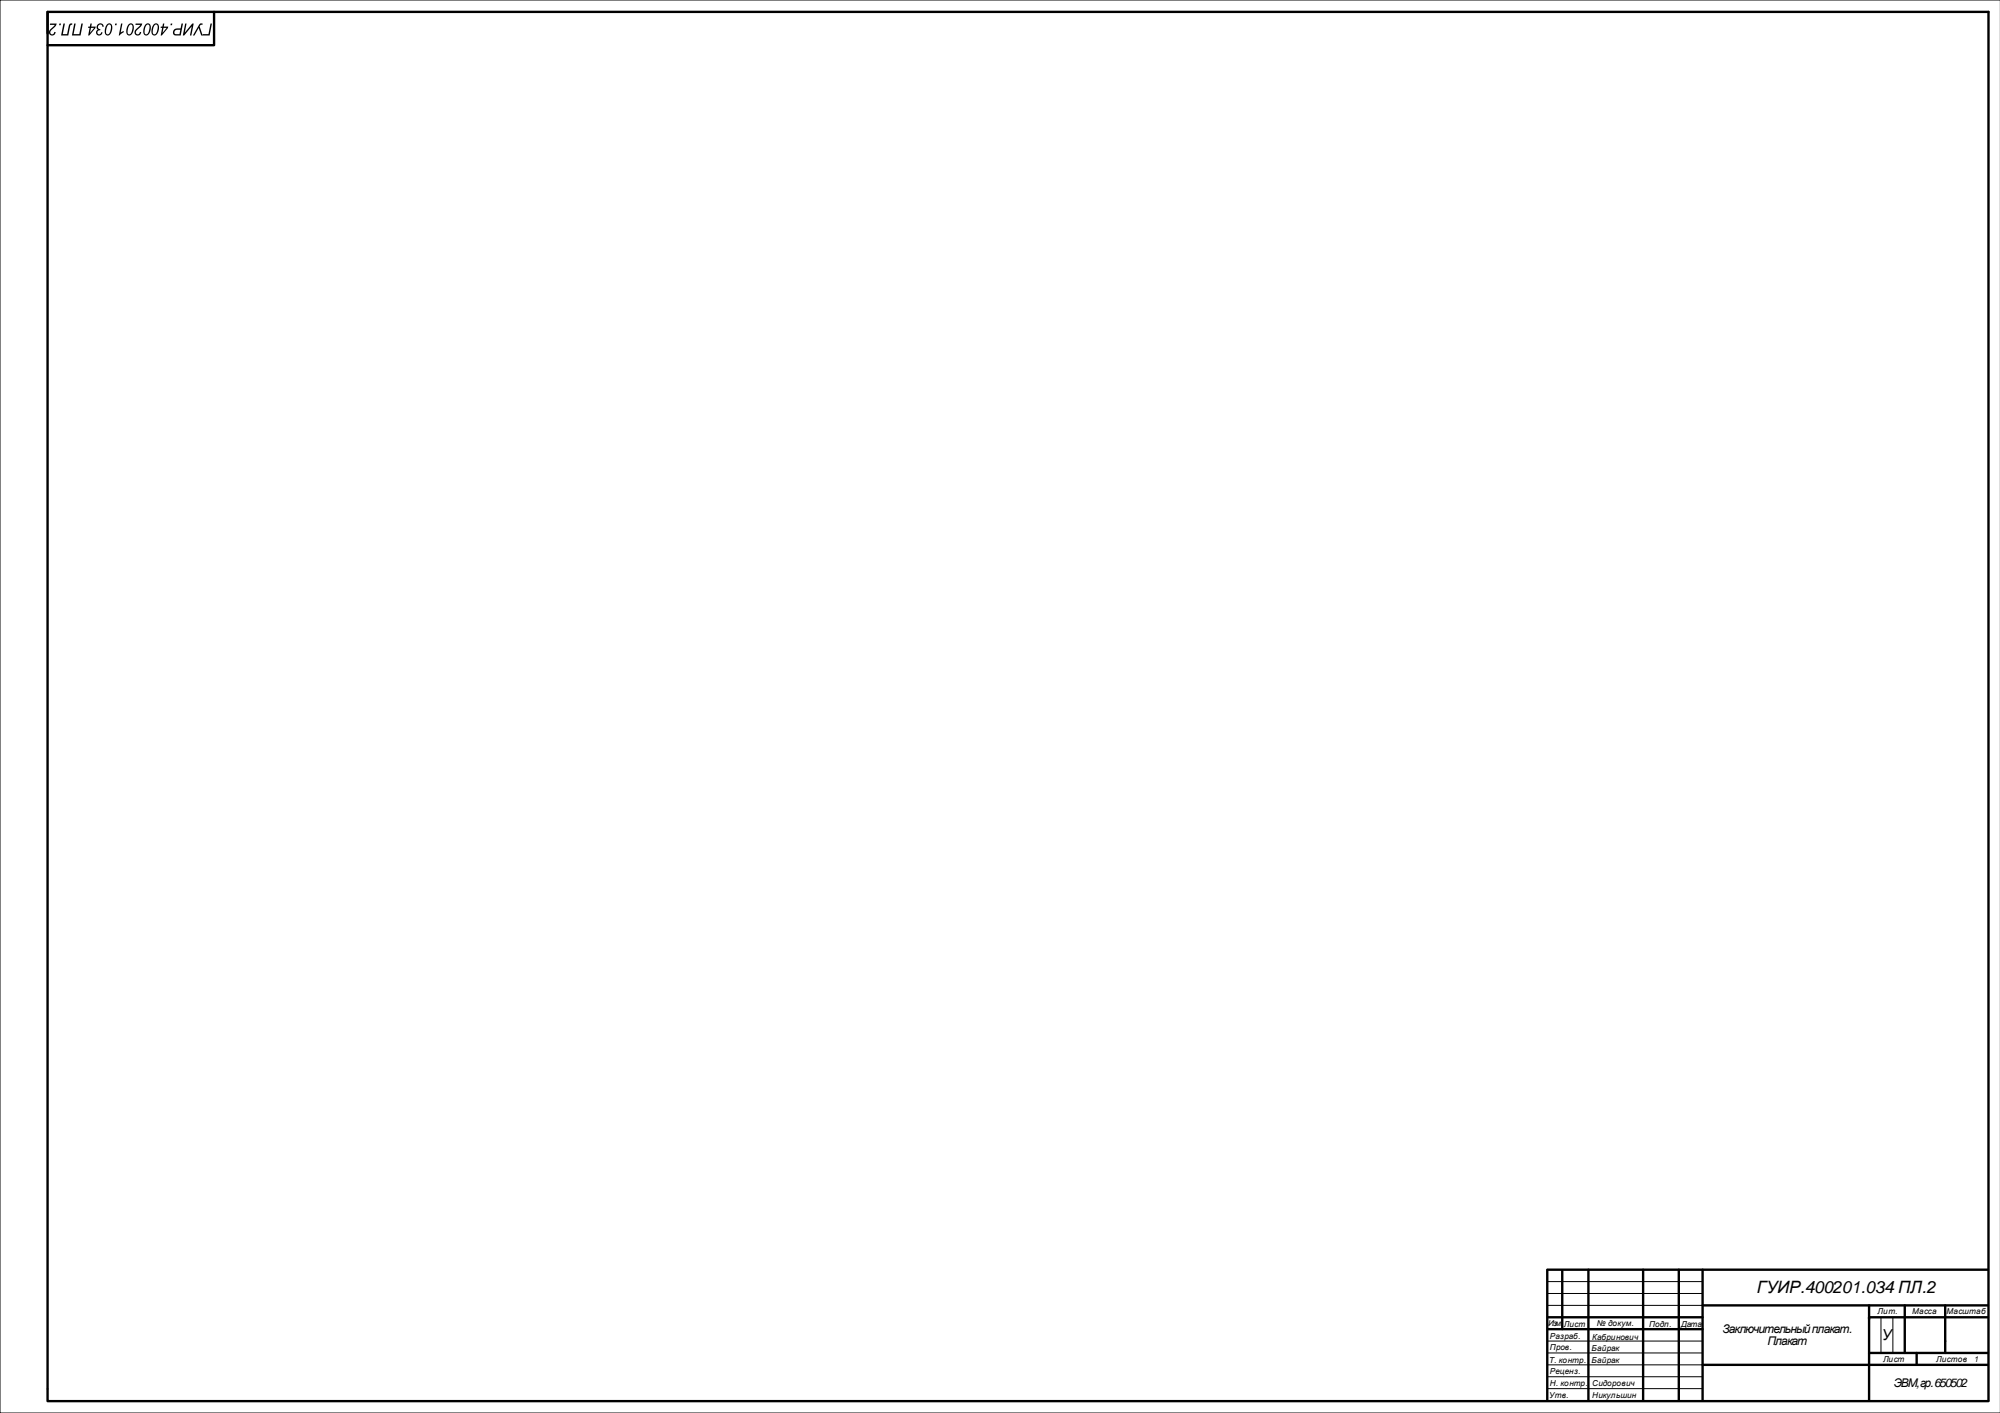
[picture p78: page 2]
Никульшин; Утв.; ЭВМ, гр. 650502

ГУИР.400201.034 ПЛ.2

Заключительный плакат. Плакат | Лит. | Масса | Масштаб

Изм.Лист | | № докум. | Подп. | Дата | | | У
Разраб. | | Кабринович
Пров. | | Байрак
Т. контр. | Байрак | | | | Лист | Листов 1
Реценз.
Н. контр. | Сидорович
