ALPause23/Diplom/PDF/ПД1.pdf

01 | 02 | 03 | 04 | 05 | 06 | 07 | 08 | 09 | 10 | 11 | 12 | 13 | 14

A

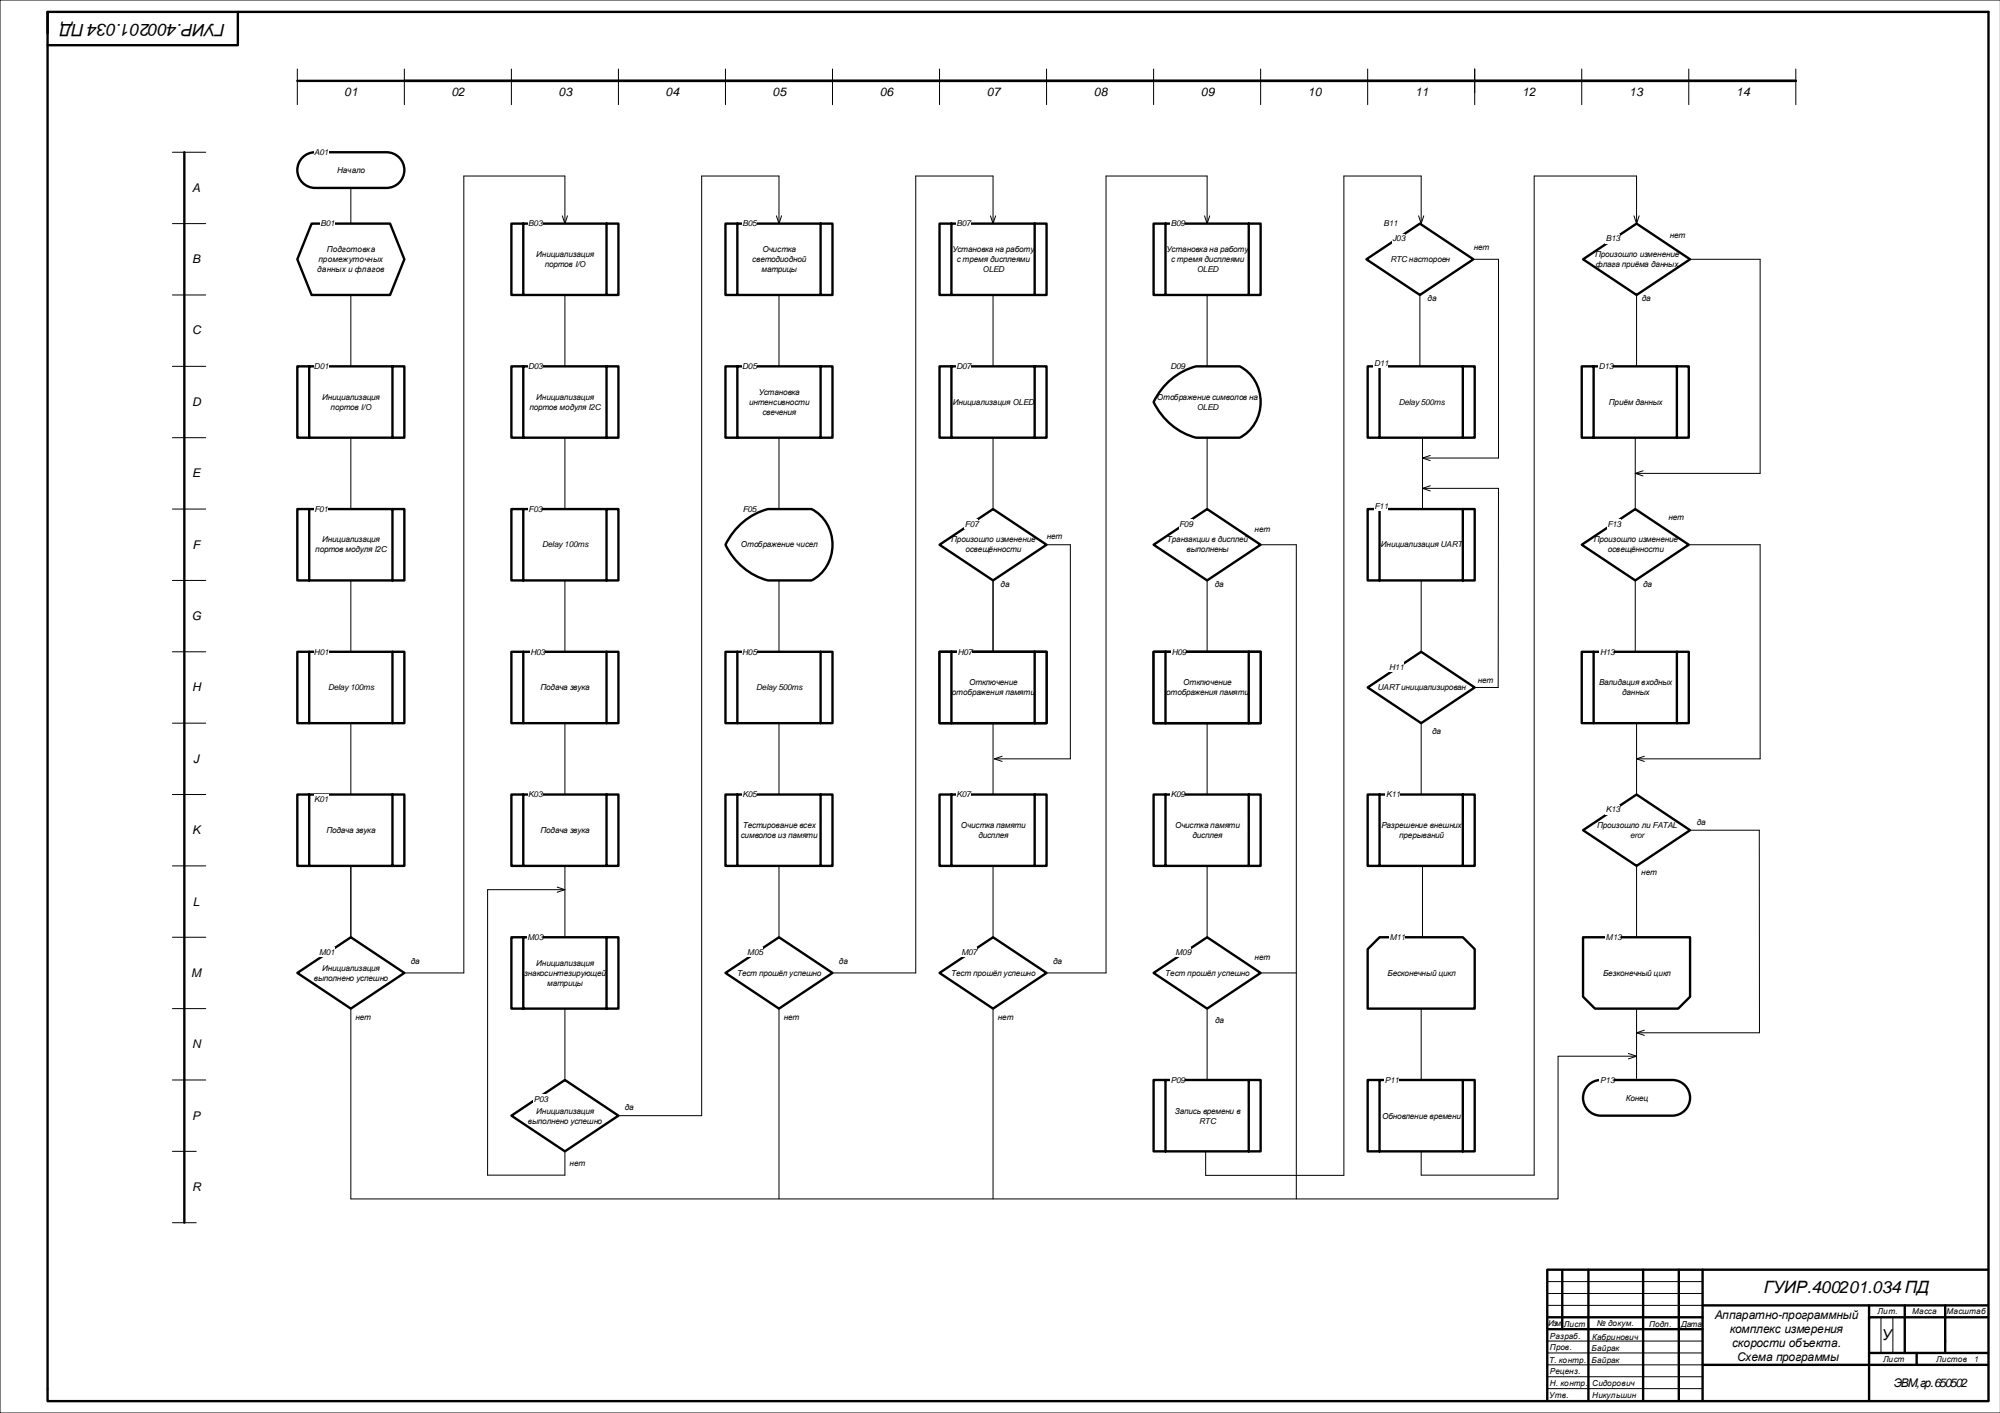
[picture p79: page 1]

да Произошло ли FATAL

ГУИР.400201.034 ПД

Аппаратно-программный комплекс измерения скорости объекта. Схема программы | Лит. | Масса | Масштаб

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
