ALPause23/Diplom/PDF/Э1.pdf

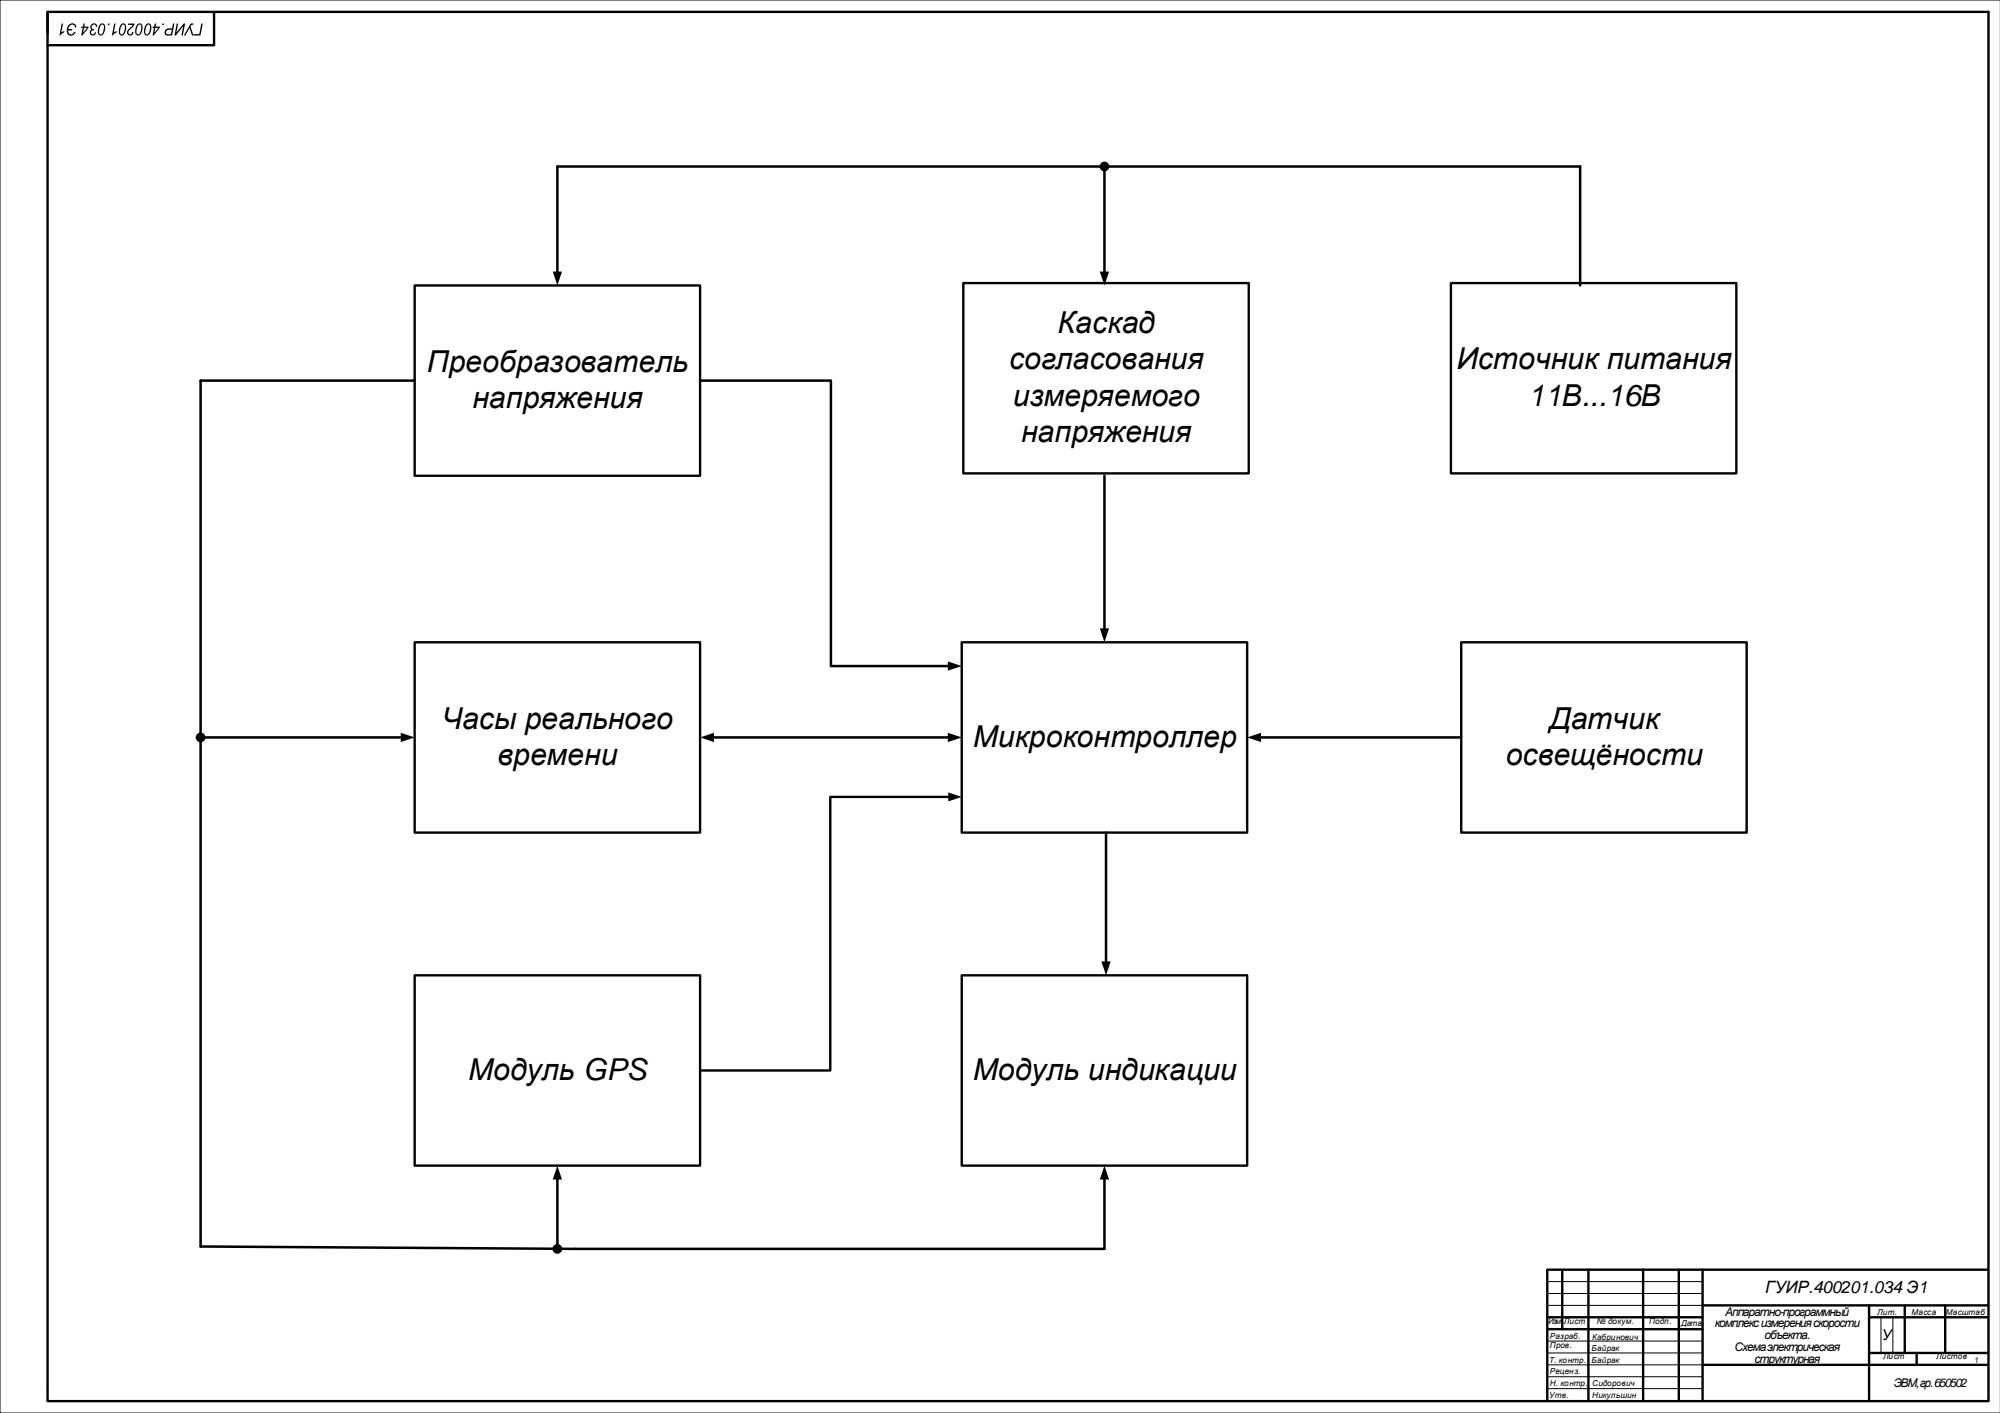
[picture p80: page 1]
Никульшин; Утв.; ЭВМ, гр. 650502; Датчик освещёности; Каскад согласования измеряемого напряжения; Источник питания 11В...16В; Преобразователь напряжения; Модуль GPS; Модуль индикации

Микроконтроллер Часы реального
времени

ГУИР.400201.034 Э1

Аппаратно-программный комплекс измерения скорости объекта. Схема электрическая структурная | Лит. | Масса | Масштаб

Изм.Лист | | № докум. | Подп. | Дата | | | У

Разраб. | | Кабринович
Пров. | | Байрак
Т. контр. | Байрак | | | | Лист | Листов 1

Реценз.
Н. контр. | Сидорович
