ALPause23/Diplom/huita/Пахолкин А.О._504541_многофункциональный GPS-спидометр/чертежи/PDF/ГУИР.467859.003 Э3.pdf

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

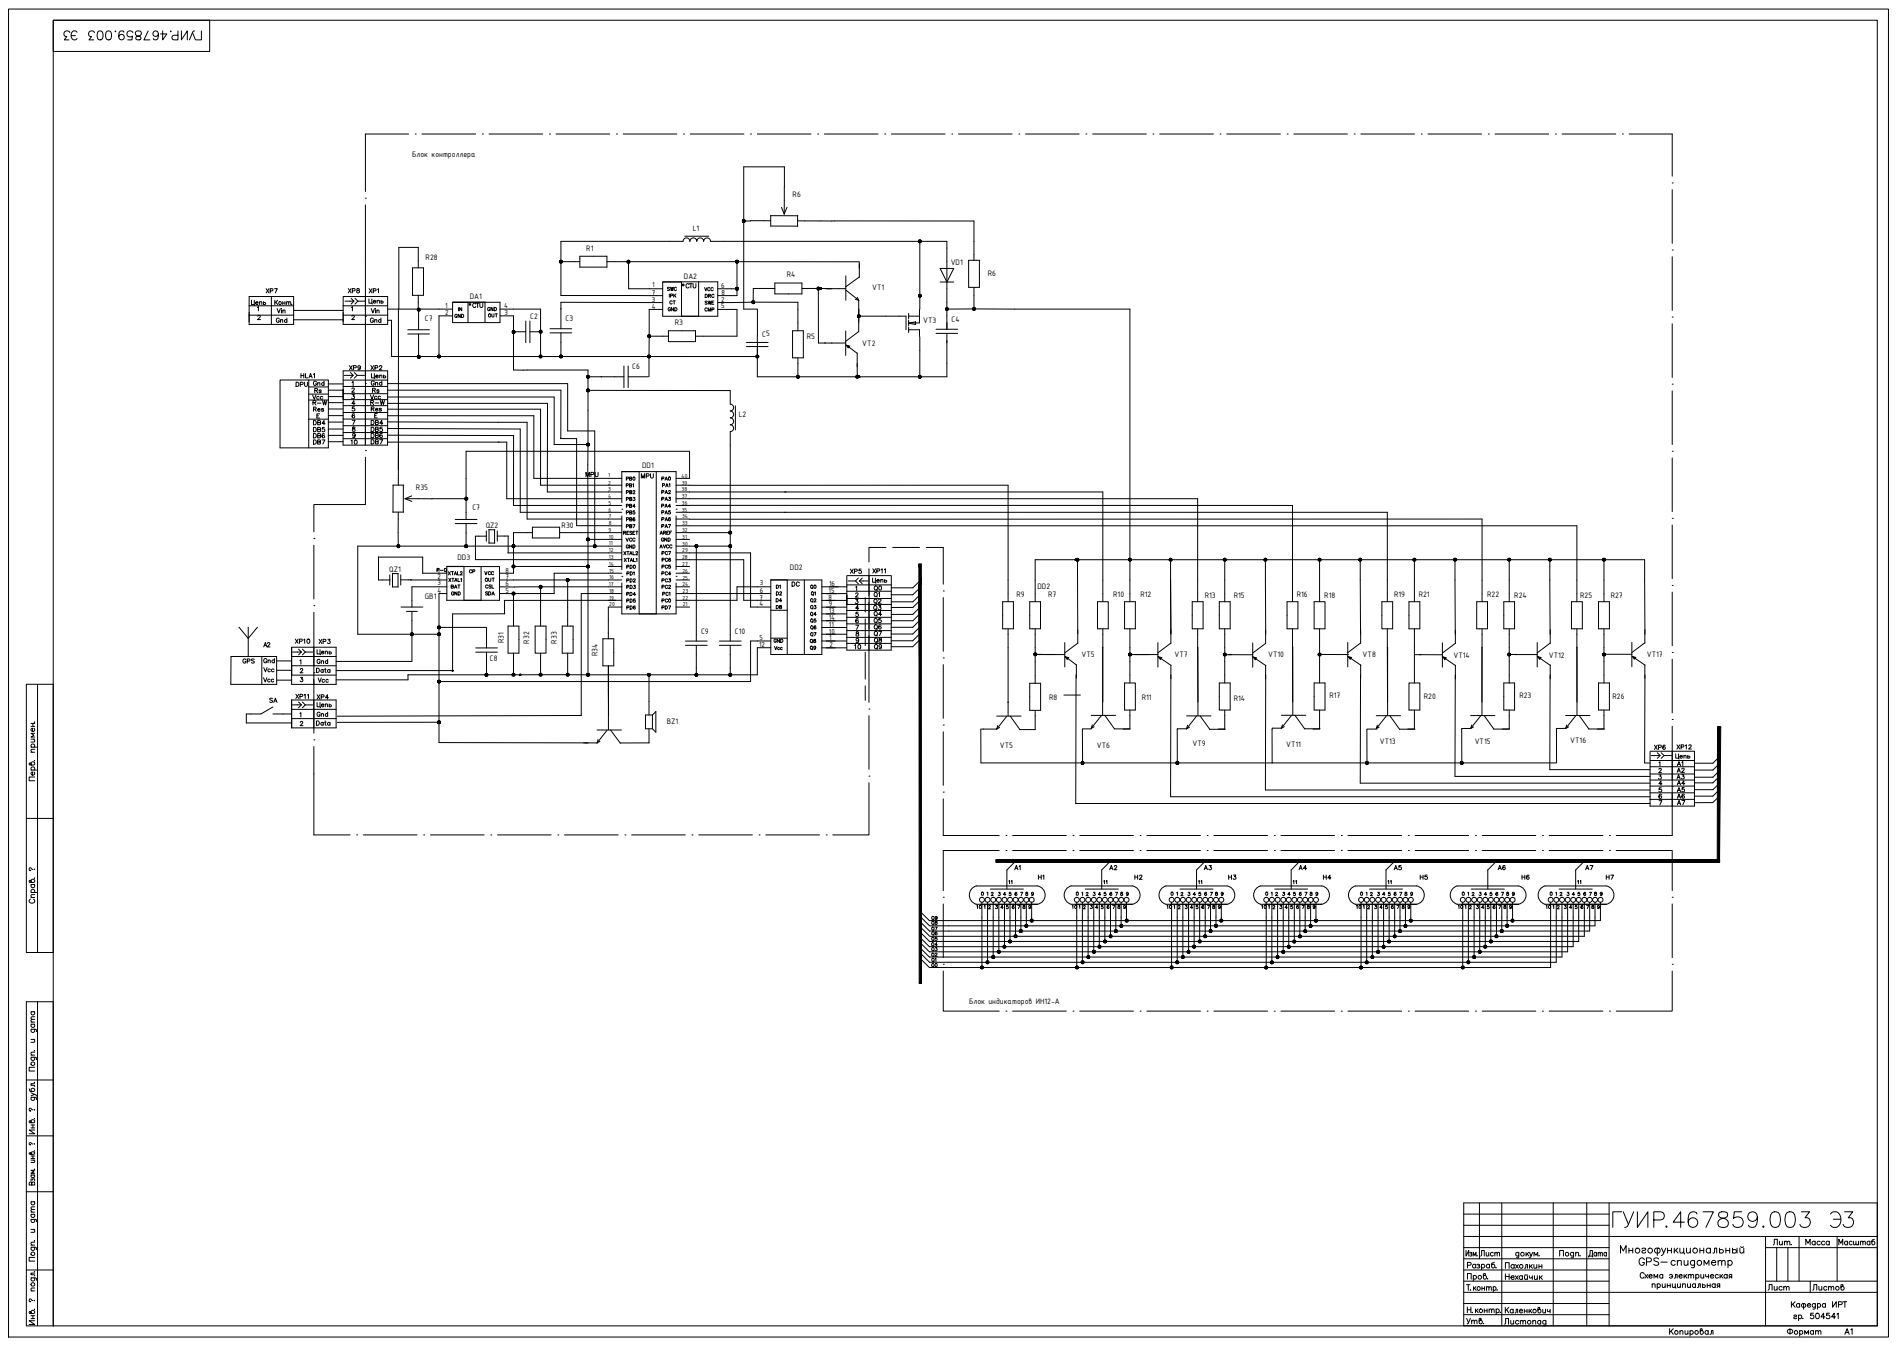
[picture p81: page 1]
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
