ALPause23/Diplom/huita/Пахолкин А.О._504541_многофункциональный GPS-спидометр/чертежи/PDF/Вспомогательный материал/Рамка-плакат.pdf

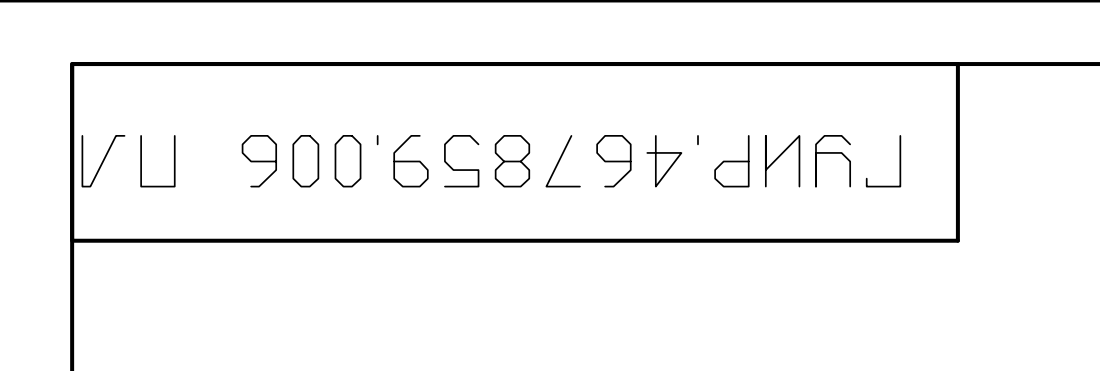
[picture p82: page 1]
