ALPause23/Diplom/(list of files, drawings)

Other design files:
huita/GPS_Lamp/gps_lamp.pdsprj
huita/GPS_Lamp/sounds/New Project.pdsprj
huita/GPS_Lamp/sounds/sound.lay6
huita/Пахолкин А.О._504541_многофункциональный GPS-спидометр/чертежи/Алгоритм программы.spl7
huita/Пахолкин А.О._504541_многофункциональный GPS-спидометр/чертежи/Э1.spl7
huita/Пахолкин А.О._504541_многофункциональный GPS-спидометр/чертежи/Э2.spl7
Shema/PA1.spl7
