ALPause23/Diplom/(commit log)

2020-05-17 Создан репозиторий
    [New Project.pdsprj, PA1.spl7, gps_lamp.pdsprj, sound.lay6, Алгоритм программы.spl7, Рамка А1-горизонтальное расположение.dwg, СБ.dwg, ЧПП.dwg]
2020-05-18 структурная переделана
2020-05-18 Create ПЗ v1.0.pdf
2020-05-19 update Э2
2020-05-19 э3 ГОТОВО
2020-05-20 последний апгрейд
2020-05-21 Добавил новые файлы
2020-05-21 Update Ведомость документов.vsd
2020-05-22 отправлял нормоконтролёру
2020-05-23 отредактирован Э2
2020-05-23 добавлена документация
2020-05-23 ДОБАВЛЕНАсхема програмы
2020-05-23 изменено название
2020-05-24 изменена схема програмы
2020-05-25 Изменён плакат. v0.1
2020-05-25 Изменён плакат. v0.2
2020-05-25 добавлена спецификация и перечни. НЕИЗМЕНЕНЫ!!!
2020-05-25 обновление реферата
2020-05-25 Update Перечни и спецификация.vsd
2020-05-25 ведомость готова
2020-05-25 Спецификация готова
2020-05-25 второй лист разлинеен
2020-05-26 Первая страница перечня готова
2020-05-26 доделана перечень
2020-05-26 Отправил на нормоконтроль
2020-05-26 Последний апдейт. Нормоконтролёр доволен
2020-05-26 Добавление пдф
2020-05-26 пишем записку
2020-05-29 Поменял содержание в ЛЗ и перечень. Дописать тестирование
2020-05-29 Добавили раздел тестирования
2020-05-29 измененны перечни и Э2. они готовы
2020-05-30 Изменён Э3
2020-05-31 ПЕРЕДЕЛАН э3
2020-06-01 Изменена рамка. Исправлена ведомость документов
2020-06-01 дописана ПЗ
2020-06-02 отредактировано пз
2020-06-03 Изменена презентация и образ
2020-06-07 Обновлены данные
